diyruz/flower/firmwares/README.md

Downalod from github [releases](https://github.com/diyruz/flower/releases)
