diyruz/flower/images/device.jpg

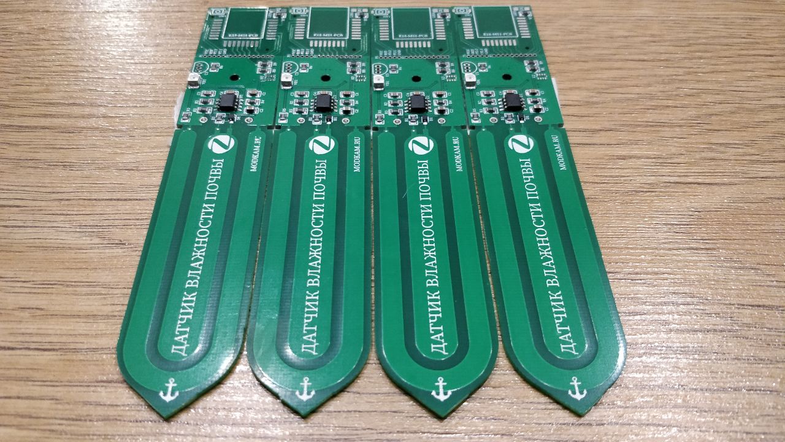
images/device.jpg
