diyruz/flower/hardware/v2/BOM_Flower_V2.xlsx

ID | Name | Designator | Footprint | Quantity
1 | 1N4148WS T4 | D1 | SOD-323_L1.8-W1.3-LS2.5-FD | 1
2 | 0.5pF | C1 | C0805 | 1
3 | 1M | R2 | R0805 | 1
4 | 220uF 10V CASE-D | C2 | CAP-SMD_L7.3-W4.3-R-RD | 1
5 | AAA_HOLDER (https://aliexpress.ru/item/32890176827.html) | G$1 | AAA_HOLDER | 1
9 | 1K | R4 | R0805 | 1
10 | T.Switch3x4x2 (https://s.click.aliexpress.com/e/_dXW0BgH) | SW1 | SWITCH-3.0*4.0 | 1
11 | 3528-PTSM D3528 (https://lcsc.com/product-detail/Ambient-Light-Sensors_JCHL-Shenzhen-Jing-Chuang-He-Li-Tech-3528-PTSM-D3528_C242256.html) | VD1 | LED-SMD_L3.5-W2.8-LS3.6-RD | 1
13 | DS18B20 (https://s.click.aliexpress.com/e/_dSyrU41) | U2 | TO-92-3_L4.9-W3.7-P1.27-L | 1
14 | 10K | R3*,R1 | R0805 | 2
15 | E18-MS1-PCB (https://s.click.aliexpress.com/e/_dZlpYLx) | U6 | E18-MS1-PCB_FLOWER | 1
16 | LED1206 | LED1 | LED 1206 | 1
17 | BME280 (https://s.click.aliexpress.com/e/_dTR9wKV) | U1 | LGA-8_BME280 | 1
18 | BME280 (https://s.click.aliexpress.com/e/_Bf9ER9sh) | U3 | DIP-1X4P2.54 | 1
19 | BS-2-1 (https://s.click.aliexpress.com/e/_dU8ZTmv) | B1 | CR2032 | 1
