diyruz/flower/(threads)

Thread 1 (2020-10-16):

Not really an issue but a question and a request

jumping2000, 2020-10-16:
Hi,
just two questions;

1. does the "flower" firmware work only with bme280 sensor?
2 I read here https://modkam.ru/?p=1671 that the measurement and transmission interval is 1 minute, is it possbile to change to 15 minute?

thank you for the great work

nurikk, 2020-10-26:
Hi, reporting interval is 30 minutes. It only supports bme280 and ds1820 sensors

jumping2000, 2020-10-30:
Perfect! thank you!

Closed 2020-10-30.

Thread 4 (2020-11-29):

buy asselbled sensor

Bartekn86, 2020-11-29:
Hi,
Where can i buy it  ? :-)

Zaitsev-ap, 2020-12-07:
> Hi,
> Where can i buy it ? :-)

Hi, buy it at telegram group
https://t.me/zigberu

Bartekn86, 2020-12-07:
thanks for replay,
Is there any other option to buy it ? tinde ?   this telegram group is hard for me :-) hard to translate :-)))

maumi, 2021-01-30:
where do you live? Which country?

Bartekn86, 2021-01-30:
poland

maumi, 2021-01-30:
Reed counter? I use a simple variant with cc2530 to count my gas counter.

Bartekn86, 2021-01-30:
cc2530 will drill  battery to fast

maumi, 2021-01-30:
It's not a problem of the cc2530. On a cold day you have 2000-4000 events (open+close) so you won't find a device battery based which lasts long.
Why not ac-powered?
Btw: i think we should stop being OT

Thread 5 (2020-12-09):

custom sensor

jumping2000, 2020-12-09:
I built a custom and very compact version of  your "flower" sensor  with only BME280 sensor and It seems to work!
the only problem is with the attribute exposed to Home Assistant, I have some attribute with "_1", maybe there is something strange in the "converter file"?

battery: 100
humidity: 88.42
illuminance: 2959
illuminance_1: 2954
illuminance_lux: 2
illuminance_lux_1: 2
linkquality: 33
pressure: 964.7
soil_moisture: 100
temperature_1: 21.21
temperature_bme: 22.6
voltage: 3500
unit_of_measurement: °C
friendly_name: 0x00124b001bdd56d3_temperature
device_class: temperature

thank you

jumping2000, 2020-12-09:
I use 2.03 firmware and related "conveerter file"

nurikk, 2020-12-20:
z2m natively supports this sensor, no external converter required

jumping2000, 2020-12-24:
> z2m natively supports this sensor, no external converter required

I removed the converter from z2m configuration but I have some strange data ending with "_1", is it normal?

{
    "battery": 52,
    "humidity": 64.48,
    "humidity_1": 47.71,
    "illuminance": 1911,
    "illuminance_1": 2615,
    "illuminance_lux": 2,
    "illuminance_lux_1": 2,
    "linkquality": 36,
    "pressure": 979.3,
    "pressure_1": 965,
    "soil_moisture": 100,
    "temperature_1": 26.61,
    "temperature_bme": 19.7,
    "voltage": 2900
}

jumping2000, 2021-01-13:
solved after 2-3 re-pairing end new version of zigbee2mqtt, Now I have the correct sensor!

Closed 2021-01-13.

Thread 6 (2020-12-21):

Change reporting interval

maumi, 2020-12-21:
Hey I really like your sensor and using it.
I want to "abuse" some of them as temperature sensors. Would it be possible that you build a version with APP_REPORT_DELAY set to 10 Minutes?
Or otherwise do i really need IAR to compile it on my own?
Thanks

maumi, 2020-12-22:
Changing the report interval in the converter did the trick.
I also compiled it on my own (with IAR) but something seems to gone wrong. The first app_delay after startup works (for exampe 5 Minutes) but then the device resend every second and won't sleep.

PS: Since your converter code is included in z2m converter you could change the readme because it's not necessary anymore.

Closed 2020-12-22.

Thread 7 (2021-01-13):

Connection issues

ftp27, 2021-01-13:
I've just finished my the very first device and faced with a problem with a strange behaviour when it already paired. A led continues blinking from time to time (like it in pair mode) and I don't see any updates from the device except finished interview by zigbee2mqtt and state:
```json
{
    "battery": 16,
    "soil_moisture": 100,
    "voltage": 3200
}
```
I don't know if its hardware problem or software but PCB has the minimum amount of components, the build only for soil moisture measures. Is it compulsory to have the whole set of sensors for the firmware (v2.0.4) and what can affect to such behaviour?

mkocus, 2021-02-06:
Got similar issue. It was basically caused by issue on the PCB assembly and/or zigbee interference with BT/WiFI.
It seems that the sensor was was not able to be configure correctly somehow.

ftp27, 2021-04-09:
So. I've soldered another board. With components
- R1, R2, R4
- C1
- D1
- LED1
- SW1
- U6
- CR2032
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
Only for soil humidity measure. Its still nothing but now I receive more data
```
{
    "battery": 14.5,
    "illuminance": 6,
    "illuminance_1": 16,
    "illuminance_lux": 1,
    "illuminance_lux_1": 1,
    "linkquality": 91,
    "pressure": 0,
    "soil_moisture": 0,
    "temperature_bme": 0,
    "voltage": 2900
}
```
The battery is new, but shows 14.5% Is it possible that firmware didn't adapt for CR2032 battery?

RomanDidenko, 2021-04-09:
C2 is required with CR2032

ftp27, 2021-04-09:
@RomanDidenko
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

ftp27, 2021-04-09:
@RomanDidenko
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
`C5` from v1 is `C2` in v2

ftp27, 2021-04-09:
After 3 hours of work the battery is dead I suppose. It stopped sending any data.

RomanDidenko, 2021-04-09:
[image: image.png]
[image: image.png]
This screenshot is taken from ready devices at https://t.me/zigberu

сб, 10 апр. 2021 г. в 01:14, Aleksei Cherepanov ***@***.***>:

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

--
Best Regards,
Roman

ftp27, 2021-04-12:
@RomanDidenko  It seems you how some problems with attachments )

RomanDidenko, 2021-04-12:
Sorry for that.
I've updated my comment but the images still not auto-expanded :(.
As I see links are valid and one can follow them.

ftp27, 2021-04-13:
@RomanDidenko Thank you for the pictures. I'll try it

GSternik, 2021-06-09:
1. I have a problem with publishing zigbee2mqtt notification of Flowers device (Domoticz).
When mqtt service is restarting I get:
cze 09 10:11:02 raspberrypi npm[503]: Zigbee2MQTT:info  2021-06-09 10:11:02: 0x00124b00225734bb (0x00124b00225734bb): DIYRuZ_Flower - DIYRuZ [Flower sensor](http://modkam.ru/?p=1700) (EndDevice)
cze 09 10:11:02 raspberrypi npm[503]: Zigbee2MQTT:info  2021-06-09 10:11:02: 0x00124b0022573477 (0x00124b0022573477): DIYRuZ_Flower - DIYRuZ [Flower sensor](http://modkam.ru/?p=1700) (EndDevice)

 Zigbee2MQTT:info  2021-06-09 08:55:37: MQTT publish: topic 'zigbee2mqtt/0x00124b0022573477', payload '{"battery":100,"illuminance":534,"illuminance_lux":1,"pressure":null,"soil_moisture":100,"temperature_ds":0,"voltage":3100}'

 Zigbee2MQTT:info  2021-06-09 08:55:37: MQTT publish: topic 'zigbee2mqtt/0x00124b00225734bb', payload '{"battery":76,"illuminance":555,"illuminance_lux":1,"pressure":null,"soil_moisture":100,"voltage":3000}'
After that the sensors do not send messages for zigbee2mqtt service.

Firstly I got message from converter:
{"dateCode":"22/04/2021 11:13","description":"[Flower sensor](http://modkam.ru/?p=1700)","friendly_name":"0x00124b00225734bb","hardwareVersion":1,"ieeeAddr":"0x00124b00225734bb","lastSeen":1623097284351,"manufacturerID":0,"manufacturerName":"modkam.ru","model":"DIYRuZ_Flower","modelID":"DIYRuZ_Flower","networkAddress":44718,"powerSource":"Battery","softwareBuildID":"22/04/2021 11:13","type":"EndDevice","vendor":"DIYRuZ"},{"dateCode":"22/04/2021 11:13","description":"[Flower sensor](http://modkam.ru/?p=1700)","friendly_name":"0x00124b0022573477","hardwareVersion":1,"ieeeAddr":"0x00124b0022573477","lastSeen":1623224768376,"manufacturerID":0,"manufacturerName":"modkam.ru","model":"DIYRuZ_Flower","modelID":"DIYRuZ_Flower","networkAddress":56759,"powerSource":"Battery","softwareBuildID":"22/04/2021 11:13","type":"EndDevice","vendor":"DIYRuZ"}],"type":"devices"}'.

2. Now I have two DS18B20 sensors in the devices. Data pins are connected to P1.3 and Vdd to P1.1. At pin P1.1 is not any voltage for supply this sensors. My guess is that it might show up when the microprocessor is waking up. However, I don't have any sensor data.
How to resolve or debbug this problems?

bojanpotocnik, 2021-06-09:
> Now I have two DS18B20 sensors in the devices.

Try with just one connected DS18B20 sensor, this device does not support reading nor reporting values of multiple DS18B20 sensors on single 1w bus. And you are correct, sensors are powered only while being read ([source](https://github.com/diyruz/flower/blob/master/Source/zcl_app.c#L238-L254)).

It is also possible that you have [counterfeit](https://github.com/cpetrich/counterfeit_DS18B20)/dead DS18B20 (happened to me).

Also, it is better to open a new issue or using more related one. Here we are waiting for @ftp27 to report and close this issue.

Thread 9 (2021-01-29):

New function or a great idea

ingo01978, 2021-01-29:
Hello, I am very excited about this project.  Now my wife got the idea to let the LED blink if the value falls below an adjustable value.  Would that be possible?  Can you set the humidity to zero by hand?  My sensors all show 20% in the dry.  LG Ingo

shajek, 2021-01-30:
Hello, i want to write about calibration. In my expirience with capacity and resistant type of probe, There is a need to use the maximum and minimum moisture calibration of the soil.  Normally is needed to bake your soil, measure minimum humidity, and water the soil to maximum  and that numbers represent as 0-100%. Is there any chance to implement min/max calibration in your great project ?

nurikk, 2021-02-01:
You're using a bad diode, try the replace it

Closed 2023-03-23.

Thread 10 (2021-01-31):

Compilation requirements

shajek, 2021-01-31:
Hello,
thank you for your work. However, can you add simple describe for IDE/enviroment where you compile FW, or what you need to compile ?

Thank you

genboo, 2021-02-01:
TI Z-Stack 3.0.2 + IAR Embedded workbench IDE (8051)

MatthijsThijssen, 2021-05-30:
Hi, Thanks for this nice project! I think I do something wrong, or maybe I am missing something...
I install the IAR Embedded Workbench environment and the Texas Instruments Z-Stack 3.0.2 but as soon as I will load the project I got a message: "Unable to create configuration "CHDTECH_DEV" using toolchain 8051" Has someone an idea? (Yes, the IAR environment and Z Stack is new for me ;-) Thanks!

bojanpotocnik, 2021-05-30:
Have you tried the steps linked by **nurikk** in issue https://github.com/diyruz/flower/issues/21?

MatthijsThijssen, 2021-06-01:
Thanks bojanpotocnik, it helps a lot. I have some compiling issues to solve (maybe because i have version 10.40 and can't find the 10.30 version)...

bojanpotocnik, 2021-06-01:
@MatthijsThijssen are you getting the following?
```
Error[e46]: Undefined external "?B" referred in bdb_Reporting ( D:\Git\diyruz\flower\CC2530DB\CHDTECH_DEV\Obj\bdb_Reporting.r51 )
Error[e46]: Undefined external "?IE" referred in ?ALLOC_XSTACK8 ( C:\Program Files (x86)\IAR Systems\Embedded Workbench 8.3\8051\LIB\CLIB\cl-pli-blxd-1e16x01.r51 )
Error while running Linker

Total number of errors: 2
Total number of warnings: 11
```

bojanpotocnik, 2021-06-01:
@MatthijsThijssen are you getting the following?
```
Error[e46]: Undefined external "?B" referred in bdb_Reporting ( ...\flower\CC2530DB\CHDTECH_DEV\Obj\bdb_Reporting.r51 )
Error[e46]: Undefined external "?IE" referred in ?ALLOC_XSTACK8 ( C:\Program Files (x86)\IAR Systems\Embedded Workbench 8.3\8051\LIB\CLIB\cl-pli-blxd-1e16x01.r51 )
Error while running Linker

Total number of errors: 2
Total number of warnings: 11
```

MatthijsThijssen, 2021-06-01:
Yes, your right! As far as i can see it is related to the current version of IAR WB 10.40

It isn't simple to get version 10.30 and i need to figure out how to solve this so i can use 10.40

I saw a message by TI website about this issue but didn't spend enough time to see if it could be solved...

MatthijsThijssen, 2021-06-01:
https://e2e.ti.com/support/wireless-connectivity/zigbee-thread-group/zigbee-and-thread/f/zigbee-thread-forum/999931/cc2530-cc2530-linking-issues-with-lates-iar-8051-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

MatthijsThijssen, 2021-06-01:
Ok, booked some succes. I changed the linker and i changed the cc2530F256.xcl file. Looks solved now. (I got a HEX file, not tested yet)

MatthijsThijssen, 2021-06-12:
Hi all, Thanks again for this nice build project! I still have some issues. I can compile the source, got a working HEX file but it differs from the original HEX file... In the original HEX file I see the LED works correct. In my compiled version the LED is very dimmed. Beside that it works but for some reason the board stopped working when the batteries are below 2.8 Volt. I think I need to do something with the compiler environment to define the correct destination (chip and/or destination environment)? Are there "thinks to know" by using the IAR development software? Thanks in advance and keep up the good work!

nurikk, 2021-07-17:
Kindly refer to this manual to setup your development environment https://zigdevwiki.github.io/Begin/IAR_install.html

Thread 11 (2021-02-02):

MQTT Configuration issue

mkocus, 2021-02-02:
Hello,
got the following configuration issue on assembled device:
```
INFO: Starting interview of '0x00124b00220281c6'
INFO: Successfully interviewed '0x00124b00220281c6', device has successfully been paired
INFO: Device '0x00124b00220281c6' is supported, identified as: DIYRuZ [Flower sensor](http://modkam.ru/?p=1700) (DIYRuZ_Flower)
INFO: Configuring '0x00124b00220281c6'
INFO: MQTT publish: topic 'zigbee2mqtt/bridge/log', payload '{"message":"interview_successful","meta":{"description":"[Flower sensor](http://modkam.ru/?p=1700)","friendly_name":"0x00124b00220281c6","model":"DIYRuZ_Flower","supported":true,"vendor":"DIYRuZ"},"type":"pairing"}'
INFO: MQTT publish: topic 'homeassistant/sensor/0x00124b00220281c6/soil_moisture/config', payload '{"availability":[{"topic":"zigbee2mqtt/bridge/state"}],"device":{"identifiers":["zigbee2mqtt_0x00124b00220281c6"],"manufacturer":"DIYRuZ","model":"[Flower sensor](http://modkam.ru/?p=1700) (DIYRuZ_Flower)","name":"0x00124b00220281c6","sw_version":"Zigbee2MQTT 1.17.0"},"icon":"mdi:water-percent","json_attributes_topic":"zigbee2mqtt/0x00124b00220281c6","name":"0x00124b00220281c6 soil moisture","state_topic":"zigbee2mqtt/0x00124b00220281c6","unique_id":"0x00124b00220281c6_soil_moisture_zigbee2mqtt","unit_of_measurement":"%","value_template":"{{ value_json.soil_moisture }}"}'
INFO: MQTT publish: topic 'homeassistant/sensor/0x00124b00220281c6/battery/config', payload '{"availability":[{"topic":"zigbee2mqtt/bridge/state"}],"device":{"identifiers":["zigbee2mqtt_0x00124b00220281c6"],"manufacturer":"DIYRuZ","model":"[Flower sensor](http://modkam.ru/?p=1700) (DIYRuZ_Flower)","name":"0x00124b00220281c6","sw_version":"Zigbee2MQTT 1.17.0"},"device_class":"battery","json_attributes_topic":"zigbee2mqtt/0x00124b00220281c6","name":"0x00124b00220281c6 battery","state_topic":"zigbee2mqtt/0x00124b00220281c6","unique_id":"0x00124b00220281c6_battery_zigbee2mqtt","unit_of_measurement":"%","value_template":"{{ value_json.battery }}"}'
INFO: MQTT publish: topic 'homeassistant/sensor/0x00124b00220281c6/illuminance/config', payload '{"availability":[{"topic":"zigbee2mqtt/bridge/state"}],"device":{"identifiers":["zigbee2mqtt_0x00124b00220281c6"],"manufacturer":"DIYRuZ","model":"[Flower sensor](http://modkam.ru/?p=1700) (DIYRuZ_Flower)","name":"0x00124b00220281c6","sw_version":"Zigbee2MQTT 1.17.0"},"device_class":"illuminance","json_attributes_topic":"zigbee2mqtt/0x00124b00220281c6","name":"0x00124b00220281c6 illuminance","state_topic":"zigbee2mqtt/0x00124b00220281c6","unique_id":"0x00124b00220281c6_illuminance_zigbee2mqtt","unit_of_measurement":"-","value_template":"{{ value_json.illuminance }}"}'
INFO: MQTT publish: topic 'homeassistant/sensor/0x00124b00220281c6/humidity/config', payload '{"availability":[{"topic":"zigbee2mqtt/bridge/state"}],"device":{"identifiers":["zigbee2mqtt_0x00124b00220281c6"],"manufacturer":"DIYRuZ","model":"[Flower sensor](http://modkam.ru/?p=1700) (DIYRuZ_Flower)","name":"0x00124b00220281c6","sw_version":"Zigbee2MQTT 1.17.0"},"device_class":"humidity","json_attributes_topic":"zigbee2mqtt/0x00124b00220281c6","name":"0x00124b00220281c6 humidity","state_topic":"zigbee2mqtt/0x00124b00220281c6","unique_id":"0x00124b00220281c6_humidity_zigbee2mqtt","unit_of_measurement":"%","value_template":"{{ value_json.humidity }}"}'
INFO: MQTT publish: topic 'homeassistant/sensor/0x00124b00220281c6/pressure/config', payload '{"availability":[{"topic":"zigbee2mqtt/bridge/state"}],"device":{"identifiers":["zigbee2mqtt_0x00124b00220281c6"],"manufacturer":"DIYRuZ","model":"[Flower sensor](http://modkam.ru/?p=1700) (DIYRuZ_Flower)","name":"0x00124b00220281c6","sw_version":"Zigbee2MQTT 1.17.0"},"device_class":"pressure","json_attributes_topic":"zigbee2mqtt/0x00124b00220281c6","name":"0x00124b00220281c6 pressure","state_topic":"zigbee2mqtt/0x00124b00220281c6","unique_id":"0x00124b00220281c6_pressure_zigbee2mqtt","unit_of_measurement":"hPa","value_template":"{{ value_json.pressure }}"}'
INFO: MQTT publish: topic 'homeassistant/sensor/0x00124b00220281c6/temperature_ds/config', payload '{"availability":[{"topic":"zigbee2mqtt/bridge/state"}],"device":{"identifiers":["zigbee2mqtt_0x00124b00220281c6"],"manufacturer":"DIYRuZ","model":"[Flower sensor](http://modkam.ru/?p=1700) (DIYRuZ_Flower)","name":"0x00124b00220281c6","sw_version":"Zigbee2MQTT 1.17.0"},"json_attributes_topic":"zigbee2mqtt/0x00124b00220281c6","name":"0x00124b00220281c6 temperature ds","state_topic":"zigbee2mqtt/0x00124b00220281c6","unique_id":"0x00124b00220281c6_temperature_ds_zigbee2mqtt","unit_of_measurement":"°C","value_template":"{{ value_json.temperature_ds }}"}'
INFO: MQTT publish: topic 'homeassistant/sensor/0x00124b00220281c6/temperature_bme/config', payload '{"availability":[{"topic":"zigbee2mqtt/bridge/state"}],"device":{"identifiers":["zigbee2mqtt_0x00124b00220281c6"],"manufacturer":"DIYRuZ","model":"[Flower sensor](http://modkam.ru/?p=1700) (DIYRuZ_Flower)","name":"0x00124b00220281c6","sw_version":"Zigbee2MQTT 1.17.0"},"json_attributes_topic":"zigbee2mqtt/0x00124b00220281c6","name":"0x00124b00220281c6 temperature bme","state_topic":"zigbee2mqtt/0x00124b00220281c6","unique_id":"0x00124b00220281c6_temperature_bme_zigbee2mqtt","unit_of_measurement":"°C","value_template":"{{ value_json.temperature_bme }}"}'
INFO: MQTT publish: topic 'homeassistant/sensor/0x00124b00220281c6/linkquality/config', payload '{"availability":[{"topic":"zigbee2mqtt/bridge/state"}],"device":{"identifiers":["zigbee2mqtt_0x00124b00220281c6"],"manufacturer":"DIYRuZ","model":"[Flower sensor](http://modkam.ru/?p=1700)
INFO: MQTT publish: topic 'homeassistant/sensor/0x00124b00220281c6/linkquality/config', payload '{"availability":[{"topic":"zigbee2mqtt/bridge/state"}],"device":{"identifiers":["zigbee2mqtt_0x00124b00220281c6"],"manufacturer":"DIYRuZ","model":"[Flower sensor](http://modkam.ru/?p=1700) (DIYRuZ_Flower)","name":"0x00124b00220281c6","sw_version":"Zigbee2MQTT 1.17.0"},"icon":"mdi:signal","json_attributes_topic":"zigbee2mqtt/0x00124b00220281c6","name":"0x00124b00220281c6 linkquality","state_topic":"zigbee2mqtt/0x00124b00220281c6","unique_id":"0x00124b00220281c6_linkquality_zigbee2mqtt","unit_of_measurement":"lqi","value_template":"{{ value_json.linkquality }}"}'
ERROR: Failed to configure '0x00124b00220281c6', attempt 1 (Error: Bind 0x00124b00220281c6/1 genPowerCfg from '0x00212effff065bda/1' failed (Error: status: 140) at DeconzAdapter.<anonymous> (/zigbee2mqtt-1.17.0/node_modules/zigbee-herdsman/dist/adapter/deconz/adapter/deconzAdapter.js:660:23) at Generator.next (<anonymous>) at fulfilled (/zigbee2mqtt-1.17.0/node_modules/zigbee-herdsman/dist/adapter/deconz/adapter/deconzAdapter.js:24:58))
```

My hardware configuration is:
- modkam.ru flower sensor, running 2.0.5 firmware
- rasberry pi running Home Assistant (latest version)
- Conbee2 zigbee coordinator
- Zigbee2MQTT

Any ideas?

mkocus, 2021-02-06:
It seems that the issue was caused by the zigbee interference or badly assembled sensor. I've assembled 2 more, and didn't have that issue again. Closing.

Closed 2021-02-06.

Thread 13 (2021-02-13):

Soil moisture scalling

mkocus, 2021-02-13:
Would it be possible to provide some interface to scale the soil moisture to a given range?

My sensor shows 0% when in air, 100% when plant is fully watered, but when the plan soil is very dry (depends on the soil type) it shows like 60 or 80.

nurikk, 2021-03-07:
no plans for implementing this, contributions are always welcome

Bartekn86, 2021-10-16:
+1

I have the same readings, 100 % max, minumum 70 %...    if it is possible, could you write some calibration ?

thank you

Thread 14 (2021-02-24):

не отсылает данные

Garkus98, 2021-02-24:
Здравствуйте. я собрал датчик и загрузил прошивку последнюю. он заджойнился в устройстве sls gateway но не отсылает никакие данные. потом я пытался и прошивал другой датчик разными прошивками но увы они не отсылают тоже данные
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

Closed 2021-02-24.

Thread 15 (2021-03-28):

Phototransistor polarity

senarvi, 2021-03-28:
I'm confused about which way I should mount the phototransistor. I found the [datasheet](https://datasheet.lcsc.com/szlcsc/1912271606_JCHL-Shenzhen-Jing-Chuang-He-Li-Tech-PTSMD3528_C242256.pdf) and it says that the notch marks the anode. I guess that means the emitter, i.e. the end that is connected to the resistor. Also in the board there's a dot marked on that side, so I would think that the notch in the phototransistor should be placed where the dot is. However, in the [pictures](https://github.com/diyruz/flower/blob/master/images/DIYRuZ_Flower_8.png) it looks like the notch is on the other side. Also, when measuring the resistance I get maybe more sane values (100 Ω - 100 kΩ depending on the light) when I place the positive probe to the notch side, so that makes me think that the notch marks the collector, but I don't know if I can measure the resistance reliably with a digital multimeter.

Thread 16 (2021-04-12):

Update interval of the sensors

shadowmdk, 2021-04-12:
Is it possible to reduce the sensor update interval to 15 minutes, or better than 10? As a meteosensor, the current interval is absolutely not informative

nurikk, 2021-04-22:
You can build firmware by yourself and define any intervals

mrazekfilip, 2021-04-28:
Where can I find definition of update interval in the firmware code? From my experience the update interval is 30 minutes, but I found only minimumReportInverval, maximumReportInterval which is set to 0 and 3600 respectively.

nurikk, 2021-04-30:
it's called `APP_REPORT_DELAY`

Thread 17 (2021-04-17):

Mention in README how to purchase these

onedr0p, 2021-04-17:
I know there's some fun to have these boards created but I don't know why it's not mentioned on the README. What is the current way to purchase and built these devices?

bojanpotocnik, 2021-04-22:
I ordered them as described on the [author's article](http://modkam.ru/?p=1832)
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
That is 4.13$ delivered to my door (customs handled by JLCPCB because I selected that option and it was included in shipping price).

The only thing I needed to solder was the battery holder, which is also the easiest part to solder, or at least worth to learn a bit of soldering for the price difference.

Already happily using more than half of them :)

jamiekris, 2022-07-07:
Is there any way now to get a hold of this kit? Does this ship from Russia?

Closed 2023-10-11.

Thread 18 (2021-04-19):

E18 MS1PA2-PCB

shajek, 2021-04-19:
Hello, please, is there any FW for E18 MS1PA2-PCB ? Please, can you compile it for this module ? I need it for longer range in garden and i have it already soldered then i realize, that FW for E18 MS1-PCB is not compatibile due PA.

Thank you

nurikk, 2021-04-22:
Hi, there is no MS1PA2 build. You can build it on your own

bojanpotocnik, 2021-04-22:
I suggest you add a repeater using yours or similar module (like [this one](https://github.com/tube0013/tube_gateways/tree/main/tube_cc_router) using [RF-BM-2652P2](https://www.szrfstar.com/product/237-en.html)), but with IPEX connector and external antenna instead of PCB antenna ([any](https://www.aliexpress.com/wholesale?SearchText=ipex+antenna) will do)! Well, I don't know your case, but maybe even the simplest CC253x repeater will do.

In this case, you have the following benefits:
- You can use plenty of [Flower v3](http://modkam.ru/?p=1832) costing you <5$ per piece delivered to your door (JLCPCB assembly) which is less than cost of E18 MS1PA2-PCB alone
- Battery in sensors will last longer, because you don't need to power LNA in MS1PA2-PCB
- Repeater can have a larger battery or be connected to main power

I ordered 30 sensors and have 18 already set-up. In the house I use [this antenna](https://www.alfa.com.tw/products/ars-n19?variant=36473964986440) attached to repeater, outside I use [this one](https://www.alfa.com.tw/products/apa-m04?variant=36473963806792), directed to the garden, picking up 8 v3 sensors up to 60 m away (haven't tested further). So yeah, in my opinion it is not worth spending time and money for replacing modules - that's why repeaters are for.

shajek, 2021-04-26:
Thank you both :) Problem is, that module is already soldered and equipped with solar panel for energy demand. Programming and making electronics is favorite hobby.

bojanpotocnik, thank you for advice, specialy for v3 version. I am aware of concept of repeater, i have whole house covered, but making PA version with aditional solar charging is "hobby and fun" and maybe better experience :)

@nurikk thank you too, for advice. I dont own IAR, i try time trial version. Installed zstack, make all dependencies OK, make imports all right, but
```
Building configuration: GenericApp - DIYRuZ_Flower
Updating build tree...
Performing Pre-Build Action
OSAL_Math.s51
Warning[410]: B is using fixed address 0xF0. Use external label ?B instead if B is using another address C:\Components\osal\mcu\cc2530\OSAL_Math.s51 108
Warning[410]: B is using fixed address 0xF0. Use external label ?B instead if B is using another address C:\Components\osal\mcu\cc2530\OSAL_Math.s51 185
version.c
Linking
Warning[w6]: Type conflict for external/entry "GetBindingTableEntry", in module APS against external/entry in module BindingTable; function return types are different; class/struct/union types have different
sizes
Warning[w6]: Type conflict for external/entry "bindFind", in module APS against external/entry in module BindingTable; function return types are different; class/struct/union types have different sizes
Warning[w6]: Type conflict for external/entry "bindFindExisting", in module APS against external/entry in module BindingTable; function return types are different; class/struct/union types have different sizes
Warning[w6]: Type conflict for external/entry "bindIsClusterIDinList", in module APS against external/entry in module BindingTable; function types differ in parameter 1; class/struct/union types have different
sizes
Warning[w6]: Type conflict for external/entry "bindRemoveClusterIdFromList", in module APS against external/entry in module BindingTable; function types differ in parameter 1; class/struct/union types
have different sizes
Warning[w6]: Type conflict for external/entry "bindRemoveEntry", in module APS against external/entry in module BindingTable; function types differ in parameter 1; class/struct/union types have different
sizes
Warning[w6]: Type conflict for external/entry "pbindAddEntry", in module APS against external/entry in module BindingTable; function return types are different; class/struct/union types have different sizes
Error[e46]: Undefined external "?B" referred in bdb_Reporting ( C:\Texas Instruments\Z-Stack 3.0.2\Projects\flower\CC2530DB\DIYRuZ_Flower\Obj\bdb_Reporting.r51 )
Error[e46]: Undefined external "?IE" referred in ?ALLOC_XSTACK8 ( E:\8051\LIB\CLIB\cl-pli-blxd-1e16x01.r51 )
Error while running Linker

Total number of errors: 2
Total number of warnings: 9

```

because of this, i kindly ask, if you can make hex for PA2 (i know that, for CO2 meter is available)

thank you both

nurikk, 2021-05-04:
I don’t have time for PA build implementation.
https://zigdevwiki.github.io/Begin/IAR_install/

@shajek you should use IAR v 10.30 or 10.40

Closed 2021-05-04.

Thread 19 (2021-04-23):

Query U1 U2 U3

aidbish, 2021-04-23:
In the V2 picture
https://github.com/diyruz/flower/blob/master/images/DIYRuZ_Flower_V2-5.png

Are U1 U2 U3 no longer required as listed in the BOM, but in picture not installed?

grego1981, 2021-04-23:
I'd like to know if there is a flash defentive flash guide!

grego1981, 2021-04-23:
I have used the guide in this URL -->  https://zigbee.blakadder.com/Ebyte_E18-MS1-PCB.html
using the ccdebuger method --> https://ptvo.info/how-to-select-and-flash-cc2530-144/

The debuger flashes the image with error in verification (CC2530 - ID1258: Error in HEX file verification) the module does not seem to work... Is there any test file  to check?? Anyhting to test prior to flashing?

linuxrrze, 2021-04-24:
AFAIK U1 and U2 are optional sensors. If equipped their values are reported, if not (default) their values are "0".

grego1981, 2021-04-24:
OK had a breakthrough, I have managed to flash and read the chip by connecting the cc debuger to the board, ommiting the power link. I connected the battery as a power input for the chip. Now it flashes and passes the verification.

The problem of connection remains, I cannot make it connect to the gateway, I tried holding the button more than 10secs to reset to no avail.... How do youmake it connect!!??

grego1981, 2021-04-28:
The problem was the button, it was defective, I have changed it and it works when long pressing it both the VD1 and LED1 light up every 3 secs (while holding) but HA zigbee2mqtt does not find the device... Is there any procedure tojoin? Anyway to debug the behaviour?

bojanpotocnik, 2021-04-28:
@grego1981 are you sure about VD1 (PTSMD3528) also lighting up? :raised_eyebrow:

Otherwise, procedure [described here](https://github.com/diyruz/flower#how-to-join) + clicking _Permit join (All)_ in Zigbee2mqtt works for me.

grego1981, 2021-04-28:
Yes, It was to curious to me as well.... When I press and hold it flasshes 1 time and then three faster, then it does not flash at all. I'll try to upload a video of it..

grego1981, 2021-04-28:
https://drive.google.com/file/d/14oaWWbRJhI-b1aqj9ErwmWVT1dMnpDkP/view?usp=sharing

bojanpotocnik, 2021-04-28:
I tried my V3 sensors with power supply set to 3.00V/1.0mA and 3.30V/3.0mA: while LED1 shines bright white in both cases, phototransistor VD1 does not light up. Weird that yours actually shines.

Anyway, I noticed that there is IPEX/U.FL connector on your module. Are you using [E18-MS1-IPX](https://www.ebyte.com/en/product-view-news.html?id=124)? In that case you shall attach the [antenna](https://www.aliexpress.com/wholesale?SearchText=antenna+ipex), otherwise RF part cannot work.

grego1981, 2021-04-28:
Ah this does makes sense..
I bought the modules bellow and have the V2 boards.
https://www.ebay.com/itm/192164529297

grego1981, 2021-04-28:
> I tried my V3 sensors with power supply set to 3.00V/1.0mA and 3.30V/3.0mA: while LED1 shines bright white in both cases, phototransistor VD1 does not light up. Weird that yours actually shines.
>
> Anyway, I noticed that there is IPEX/U.FL connector on your module. Are you using [E18-MS1-IPX](https://www.ebyte.com/en/product-view-news.html?id=124)? In that case you shall attach the [antenna](https://www.aliexpress.com/wholesale?SearchText=antenna+ipex), otherwise RF part cannot work.

You were correct, I found and installed a 2.4 sma antenna and managed to join it. Now Have to find out why no sensor works...
Thank you for your help!

grego1981, 2021-05-04:
So the sensor got discovered and at some point the battery was detected but low (about 12%) I even saw some data from the sensors briefly but after some time, all data was N/A and only the signal strength is displayed... I deleted and rejoined to no avail, I changed the battery as well.
I use the latest released hex file.

bojanpotocnik, 2021-05-04:
Can you please configure zigbee2mqtt as such
```
advanced:
  log_level: debug
zigbee_herdsman_debug: true
```
and then provide log output after you re-join the sensor? Force remove it first, rejoin (as described in README.md in this repo) and then press the button after a while to update the state.

robotm-team, 2021-06-07:
> AFAIK U1 and U2 are optional sensors. If equipped their values are reported, if not (default) their values are "0".

I will ask because I don't know if I understand this correctly:
Will a plate made as in the photo DIYRuZ_Flower_V2-5.png, that is without U1, U2 and U3 will it only report soil moisture and insolation?
Installing U2 will add ambient temperature report?
Installing U1 or U3 will add air pressure, humidity and temperature but only ambient?
Does it make sense to install U2 if you install U1 or U3?

bojanpotocnik, 2021-06-08:
> Does it make sense to install U2 if you install U1 or U3?

I think it is meant that you add this (left one) as U2
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
and stick it in the soil - then you have soil humidity+temperature + air humidity+pressure+temperature, which makes sense again.

> nothing appears in the debug log

Have you enabled all debug as I suggested above? And LED flickers like it is sending something, but totally nothing in the log (joining new devices permitted)? In that case I am also run out of ideas... I would try with another sensor first, to test HA/Z2M setup.

robotm-team, 2021-06-20:
Hi. One more question.
From what I've read VD1 (3528-PTSM D3528) which I can't find anywhere except LCSC and supplying only this one element from there is completely unprofitable, can be replaced with any photoresistor ( https://modkam.ru/?p=1700#comment-6226 ) like the one in the link in the quoted comment. However, there is a statement which I do not understand. I don't know Russian and I'm using online translator and it's not that helpful.
Question: What should be done with the resistor (I think it's R3) in the circuit Jager writes about?
"Только резистор в цепи подберите." - What to do with it :-) ? omit it (make a jumper or solder 0Ω) ? Give more than 10KΩ ? Sorry, but the translator suggests all these possibilities ...

bojanpotocnik, 2021-06-20:
When measuring illuminance, ADC peripheral [is set](https://github.com/diyruz/flower/blob/master/Source/zcl_app.c#L288) to use AVDD as a reference voltage, which is connected to VDD, meaning that voltages up to 3.3 V can be read on ADC pins. However, the circuit will work down to 2V VDD when battery empties, so you would want to limit your measured voltage to max. 2V to prevent saturating ADC input.

Checking [3528-PTSM D3528 datasheet](https://datasheet.lcsc.com/lcsc/1912271606_JCHL-Shenzhen-Jing-Chuang-He-Li-Tech-PTSMD3528_C242256.pdf) page 3/5

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

shows you that at 100 lux the current is 59 uA, resulting in ADC input voltage U = I*R = 59 uA * 10 k = 0.59 V.

So if you want to have the same values, you should measure photoresistor's resistance at 100 lux and then adjust the R3 so that the voltage divider output will be 0.59 V. But then you have another problem - LDRs are usually not linear
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
so values won't be the same anyway, so don't bother too much. Just measure the resistance at maximum brightness and adjust R3 so that the resulting value does not go over 2V.

As example, if you take LDR info from [this page](https://www.elprocus.com/ldr-light-dependent-resistor-circuit-and-working/)
> Typical resistance at 100lux is 0.7kΩ

and put this in voltage divider [calculator](https://ohmslawcalculator.com/voltage-divider-calculator) (Vs = 3V, R1 = 700 ohm, Vout = 2 V), you get that R2 (R3) shall be 1400 ohm.

robotm-team, 2021-06-20:
Thank you so much for your help and commitment.
So, if I understand correctly this circuit is fitted to this particular type and model. Well, too bad, I will have to do without it.Unless there is some other, more easily available model of photoresistor which can simply be soldered in and will match the parameters... From the calculator it looks like it should be 5kΩ at 100Lx to match R3 (10kΩ) on the board.
Maybe someday, additionally...
Unless you have a ready solution :-) ?

Translated with www.DeepL.com/Translator (free version)

MatthijsThijssen, 2021-06-20:
This one works well:

https://nl.rs-online.com/web/p/phototransistors/7103853/

Or this one:

https://nl.rs-online.com/web/p/photodiodes/1652707/

Met vriendelijke groet / Kind Regards,

Matthijs Thijssen
The Netherlands

(Verstuurd vanaf mijn iPhone)

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

bojanpotocnik, 2021-06-21:
Also check [this comment](https://modkam.ru/?p=1700#comment-5586) - you can add [I2C light sensor](https://ae01.alicdn.com/kf/HTB1HVxiQpXXXXcWaXXXq6xXFXXXx.jpg) instead of or in addition to BME280. This would result in calibrated light measurements, but also in increased cost and need of modifying the firmware.

Thread 20 (2021-04-25):

Feature Request: OTA Updates

linuxrrze, 2021-04-25:
Not a bug, just a feature request: OTA Updates

I'd love to see OTA updates for firmware releases.
Are there any plans to realize that?

So far I've only seen that on a few IKEA devices, however it'd be great to have this feature for more devices (especially if there's active development going on as in this project).

There's some documentation about how OTA can be done (I hope the mentioned Z-Stack is the same as the one used here):

https://e2e.ti.com/cfs-file/__key/communityserver-discussions-components-files/158/6888.Z_2D00_Stack-OTA-Upgrade-User_2500_27s-Guide.pdf

PS: Thanks for sharing this great project!

nurikk, 2021-04-26:
Hi, unfortunately there’s not enough flash size for ota

chrisrock1984, 2021-04-27:
would it still be possible to do OTA if the firmware only contains the code of moisture sensing?

nurikk, 2021-04-27:
I'm not sure about this, unfortunately I don't have time for this experiments and implementation.
If you want to try implement OTA by yourself kindly refer to TI official reference guide. All contributions are always welcome

[Z-Stack OTA Upgrade User's Guide.pdf](https://github.com/diyruz/flower/files/6382002/Z-Stack.OTA.Upgrade.User.s.Guide.pdf)

Hedda, 2021-11-29:
FYI, OTA would be possible if this Flower project was redesigned to newer Texas Instruments module like CC2652, see -> https://github.com/diyruz/flower/issues/43

Closed 2021-05-04.

Thread 22 (2021-04-27):

Cut down the cost of the PCB with panelization

elysion, 2021-04-27:
PCB fabrication services charge extra for PCBs that do not fit inside 10x10cm. As the width of the v2 design seems to be 128mm, additional charges are applied. Also as the height of the board height is 24mm, you could fit 4 of these inside a single design, further cutting the costs. I realise that the cost of the PCB is one of the cheapest parts of the design, but think that small tweaks would have a good ROI.

Would it be possible for you to make these changes or share the PCB designs in order for someone else to make them?

bojanpotocnik, 2021-04-27:
@elysion check [this comment](https://github.com/diyruz/flower/issues/17#issuecomment-825236065) - v3 is less than $5 fully assembled (except battery holder) delivered to your door - it hardly gets any cheaper. Maybe try using other fabrication service?

Otherwise this is still valid request, maybe someone is willing to do it anyway. Note, however, that sensing element should be of certain minimum size to be reliable, and you want RF part to be as away from the soil as possible. Interesting design would be separating the logic/RF/upper and sensing/lower part, each having pads to connect them with a e.g. ribbon cable. That would enable using different sizes of sensing elements (smaller or larger pots) or mounting RF part on the outside of the pod (not sticking up).

nurikk, 2021-05-04:
Kindly do panelisation and submit gerbers in 0R

bojanpotocnik, 2021-05-04:
@nurikk is it possible to publish original PCB design files or make EasyEDA project public? It is much harder to reverse engineer the gerber files and not much sense in reinventing the wheel. If the original project files would be available, I am sure someone (even me when I find some spare time) would be happy to do such improvements.

bojanpotocnik, 2021-06-07:
@nurikk do you have any information on my question above, or shall I ask Jager on Telegram?

nurikk, 2021-07-22:
Jager never shares sources, forget about it

Closed 2021-05-04.

Thread 23 (2021-05-04):

Would it be possible to use this as a basis for an ultrasonic sensor?

disaster123, 2021-05-04:
Hi,

i want to build a zigbee device using an ultrasonic sensor like  JSN-SR04T-2.0 - would this be possible?

Greets,
Stefan

bojanpotocnik, 2021-05-04:
Please keep issues here related to Flower project and its firmware - which _issue_ of the latest firmware does this question address?

Anyway, answer to your question: check [Zigbee Configurable Firmware](https://ptvo.info/zigbee-configurable-firmware-features/), you can do almost anything.

Thread 24 (2021-05-05):

JLCPcb order with soldering elements problem

GSternik, 2021-05-05:
Hi, when I uploaded gerber file and bom file they require to add CPL file. Where I can find this file?

nurikk, 2021-05-11:
[In this Russian article ](https://modkam.ru/?p=1832)

Closed 2021-05-11.

Thread 25 (2021-05-08):

Unable to join v3 board to Conbee II (deconz) network

cburghardt, 2021-05-08:
I have ordered an assembled v3 board and added the BME as breakout board. Then I flashed the 2.0.8 version.
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

Now I am trying to add the sensor to my Zigbee network but it doesn't recognize the device. I am using a Conbee II stick so a Deconz software. The video shows the reaction from the sensor.

https://user-images.githubusercontent.com/839480/117554307-1cfe4000-b057-11eb-85ab-8d2b2dac9331.mp4

cburghardt, 2021-05-13:
Got it, will switch to zigbee2mqtt

Closed 2021-05-13.

Thread 26 (2021-05-17):

is it possible to use "Capacitive soil moisture sensor v1.2" with e18-ms1-pcb and this code?

errdos, 2021-05-17:
more of a question than an issue.
i was wondering if its possible (and how) to use the firmware with e18-ms1-pcb and a "Capacitive soil moisture sensor" with 3 pin
connectors.

looking over the board it seems very very similar to the sensor that i already have (Capacitive soil moisture sensor v1.2).

bojanpotocnik, 2021-05-18:
You are correct, the shape and operation principle is basically the same as for other capacitive soil moisture sensors. As written in the [README.md](https://github.com/diyruz/flower#user-content-version-1):
> The circuit for measuring soil moisture is typical for this kind of device and, in principle, repeats the Chinese sensor, with the only difference that Jager increased the frequency of the generator to 2 MHz.

If you compare [V1 schematic](https://github.com/diyruz/flower/blob/master/images/DIYRuZ_Flower_4.png) with you v1.2 sensor, you will see that the upper left part is already present on your sensor. You can try to connect analog output of your sensor to pin P0.4.

eitanV81, 2021-05-18:
first of all thanks for the info and help!

so if i read the schema correctly i can (as you mentioned) connect p0.4 to analog output and p1.1 to VDD? (guessing from the schema of version1)
i assume that the new version P1.4 is used to create up to 3 MHZ signal instead of the chip (which already exists in my sensor)?
so the questions i am left with are:
1. is the analog input of the board support up to 3.3v (i assume it does)
2. does the VDD power still works (and enough ) using P1.1
3. or should i simply jump over the whole chip of my sensor and try to implement what is done in V2.. but i find it a bit complicated to understand what does exists in my sensor and what doesn't.

do you think it's worth pursuing?
i will also try to read on Zigbee Configurable Firmware but it seems that it doesnt support sleep :( so i wont be able to use it on battery.

errdos, 2021-05-18:
first of all thanks for the info and help!

so if i read the schema correctly i can (as you mentioned) connect p0.4 to analog output and p1.1 to VDD? (guessing from the schema of version1)
i assume that the new version P1.4 is used to create up to 3 MHZ signal instead of the chip (which already exists in my sensor)?
so the questions i am left with are:
1. is the analog input of the board support up to 3.3v (i assume it does)
2. does the VDD power still works (and enough ) using P1.1
3. or should i simply jump over the whole chip of my sensor and try to implement what is done in V2.. but i find it a bit complicated to understand what does exists in my sensor and what doesn't.

do you think it's worth pursuing?
i will also try to read on Zigbee Configurable Firmware but it seems that it doesnt support sleep :( so i wont be able to use it on battery.

bojanpotocnik, 2021-05-19:
> i can (as you mentioned) connect p0.4 to analog output and p1.1 to VDD? (guessing from the schema of version1)

Yes, that should work. P1.1 is used instead of V3.3 to decrease power consumption - so the sensor is powered (3.3V from P1.1) only for short time.

[CC2530 datasheet](https://www.ti.com/lit/ds/symlink/cc2530.pdf) pages 11, 18.

> 1. is the analog input of the board support up to 3.3v (i assume it does)

Yes, input voltage is 0-VDD V, where VDD is voltage on AVDD5 pin.

> 2. does the VDD power still works (and enough ) using P1.1

```plain
| P1_1 | 9 | Digital I/O | Port 1.1 – 20-mA drive capability
```
Yes, P1.1 is one of the 2 IO pins capable of 20 mA. Your sensor shall consume much less, but you can measure to be sure.

> 3. or should i simply jump over the whole chip of my sensor and try to implement what is done in V2.. but i find it a bit complicated to understand what does exists in my sensor and what doesn't.

That would work. You can compare V1 schematic with your sensor, then V1 with V2 to see changes. Power consumption would be lower for sure, because you don't need to power 555 on your sensor. You would connect P1.4 to where pin 3 of 555 chip goes on your sensor, but first make sure that non-powered OUT pin of existing 555 does not consume anything.

Thread 27 (2021-06-12):

Проблема с датчиком DS18B20

gumileeev, 2021-06-12:
Для v3 мною были закуплены датчики DS18B20 по этой ссылке: https://aliexpress.ru/item/1783091649.html
После их установки - я получаю только 2 значения с датчика температуры: 0 и 25 градусов, значения рандомные, ни от чего не зависят. Я предполагаю, что датчики могли быть неоригинальные. Прошивку использую 2.08. Пробовал 2.05, но ситуация не меняется. В отзывах пишут о том, что должно быть какое то "паразитное" питание. Подскажите, есть ли возможность исправить эту проблему?

bojanpotocnik, 2021-06-14:
Similar happened to me - one batch of cheap sensors (20 pcs) from AliExpress always show exactly 25.0°C. You have [counterfeit DS18B20](https://github.com/cpetrich/counterfeit_DS18B20) sensors... Read reviews before buying, hope for some luck (I bought many OK DS18B20 from eBay and AliExpress in the past), or buy from legit suppliers (LCSC, Farnell, DigiKey, RS, Mouser, local electronic components stores, ...).

gumileeev, 2021-06-17:
> Similar happened to me - one batch of cheap sensors (20 pcs) from AliExpress always show exactly 25.0°C. You have [counterfeit DS18B20](https://github.com/cpetrich/counterfeit_DS18B20) sensors... Read reviews before buying, hope for some luck (I bought many OK DS18B20 from eBay and AliExpress in the past), or buy from legit suppliers (LCSC, Farnell, DigiKey, RS, Mouser, local electronic components stores, ...).

Спешу сообщить, что уважаемый Jager поделился со мной другой версией прошивки 2.0.8, к ней прилагался скрин, возможно по нему вы сможете определить, какая именно это версия файла. С ней все мои датчики исправно заработали и больше не показывают 0 и 25. Вдруг вы сочтете внести такое исправление в основной релиз :)  Спасибо!
[DIYRuZ_Flower.zip](https://github.com/diyruz/flower/files/6671950/DIYRuZ_Flower.zip)
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

bojanpotocnik, 2021-06-18:
Nice! :open_mouth:  Maybe my "dead" sensors will also start working.

> Suddenly you will consider making such a fix in the main release :)

I am not sure if I understand this (can't read cyrillic) properly... Did you mean to say that @nurikk will push and merge the commit/fix soon and make version 2.0.9? I personally cannot do it, I don't know what the fix is.

gumileeev, 2021-06-25:
> Nice! 😮 Maybe my "dead" sensors will also start working.

У вас получилось? Сенсор заработал?

> Did you mean to say that @nurikk will push and merge the commit/fix soon and make version 2.0.9?

Да, я бы хотел, что бы внесли официальное исправление. Это не в моей компетенции.

gumileeev, 2021-07-05:
Сенсор температуры отлично отправляет данные на этой прошивке. Однако за 4 дня полностью расходует заряд 2хААА батареек. В следствии чего избавился от этих не оригинальных датчиков температуры и накатил оригинальную прошивку. Запрос закрываю.

Closed 2021-07-05.

Thread 28 (2021-06-24):

Help writing groovy device driver

AutomateMyLifee, 2021-06-24:
I'm trying to get this sensor working with the Smartthings/Hubitat platform. It paired easily to the hub, but I had to create my own driver. So far I have the sensors accurately reporting battery and values from BME280 (temp, humid, and pressure), but I can't get the sensor to send the correct values for the soil moisture. These are the commands I sent to configure the device so it sends data.
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
But the soil cluster (0408) is sending the attribute 0201 instead of 0000. I had it reporting the soil moisture at one point, but I must  be sending the wrong config because now it stopped sending the correct value. I checked all source code best I could, but I don't really have experience with ZigBee firmware. What am I doing wrong with the config command?
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

bojanpotocnik, 2021-06-28:
I think the problem may actually be in the SmartThings/Hubitat.

All working clusters IDs [are defines from `zcl.h`](https://github.com/diyruz/flower/blob/master/Source/zcl_app.h#L41-L47), that is standard [ZCL General Clusters](http://software-dl.ti.com/simplelink/esd/simplelink_cc13x2_26x2_sdk/4.20.00.35/exports/docs/zigbee/doxygen/zigbee/html/group___z_c_l___g_e_n_e_r_a_l___c_l_u_s_t_e_r_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) or [ZCL Measurement & Sensing Clusters](http://software-dl.ti.com/simplelink/esd/simplelink_cc13x2_26x2_sdk/4.20.00.35/exports/docs/zigbee/doxygen/zigbee/html/group___z_c_l___m_s___c_l_u_s_t_e_r___i_d_s.ht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) (there is also a reference to the same ZCL standard on the [SmartThings page](https://docs.smartthings.com/en/latest/device-type-developers-guide/zigbee-primer.html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)).

`SOIL_HUMIDITY` cluster is not part of the [ZCL v7 specification](https://zigbeealliance.org/wp-content/uploads/2019/12/07-5123-06-zigbee-cluster-library-specification.pdf), that is why its ID is the only one [manually typed](https://github.com/diyruz/flower/blob/master/Source/zcl_app.h#L45) in source, instead of using define from `zcl.h`. Consequently it is also not present within [SmartThings Capabilities](https://docs.smartthings.com/en/latest/capabilities-reference.html#capabilities-taxonomy).

[ZigBee Cluster Library Specification](https://zigbeealliance.org/wp-content/uploads/2019/12/07-5123-06-zigbee-cluster-library-specification.pdf):
- For BME, _**0x0405** Relative Humidity Measurement - **0x0000** MeasuredValue_ (**4.7.2.2.1**) is used
- For soil moisture, nonexistent cluster _**0x0408** Soil Humidity Measurement? - Relative Humidity in % - **0x0200-0xFFFE** Vendor defined_ (**3.14.11.19.1.2**) is used

So the behaviour is correct and per-specs: because Soil Humidity is not yet supported in the Zigbee standard, author chose vendor defined Relative Humidity type 0x0201 out of range 0x0200-0xFFFE for vendor defined types.

bojanpotocnik, 2021-07-24:
@AutomateMyLifee try with the new release [2.1.0](https://github.com/diyruz/flower/releases/tag/2.1.0), if there will be any difference.

AutomateMyLifee, 2021-07-26:
I haven't found any more success. The new firmware give the same behavior, except there is some warning about the endpoint 2. So you are saying that the value from cluster 0x0408 and attribute 0x0201 should give soil humidity? I tried putting the sensor in water and in air and this value stays basically the same. Isn't it in the [source code](https://github.com/diyruz/flower/blob/e4cb8726fa5d75605b4298160d12e1dfa0b26df1/Source/zcl_app.c#L273) that the attribute should MeasuredValue, which is 0x0000?

Thread 29 (2021-07-03):

Source code issue

MatthijsThijssen, 2021-07-03:
Hi all,

First of all: I would like to thank all of you working on this nice project!

To implement it in my environment i would like to make some changes. Before i can do this i try to compile the actual source version but i have some issues...

First of all: I build the developemt environment exactly as described. So far so good. I can compile the source code but for some reasons i have the following issues:

- The output Flower_CHDTECH.HEX file is 536KB in relation to the posted DIYRuZ_Flower.HEX, which is 455 KB in size...
- The consumed power of the generated Flower_CHDTECH.HEX is much higher which makes that battery period is much shorter.
- The LED is nearly not visible, this is in the org DIYRuZ_Flower perfect, so it is an  firmware issue...

Maybe there are more different things, but this is what i see after compiling the posted source (without changing any code).

Are there "Things to know and define" in the development environment before compile?
Is the source outdated in relation to the available HEX file?

Please let me know, i like the porject but i need to have it current before i can start to implement it and work on it...

Thanks in advance!
Matthijs

bojanpotocnik, 2021-07-16:
> Things changed, you need IAR version 10.30...

@MatthijsThijssen, I suggest you recover your original comment and add this as and EDIT: below.

I think we will resolve this eventually. Personally I wouldn't be happy with myself providing "just use older version of the tool" as a requirement or solution. Things do change, but in case of compilers usually for the better. I have IAR 10.40.1 installed, have compiled this repo successfully, but haven't had a time to test and debug it yet. It seems like also @nurikk cannot dedicate much time to this project, but eventually someone will find a fix for newer version and this issue could be properly closed. Maybe you can change the title for something more related, e.g. "Compiling using IAR version higher than 10.30".

Relates to #10.

nurikk, 2021-07-16:
Nothing has been changed in zstack 3.0.2 since 2007... So sticking to old version or IAR is a good idea.

Here is download link
http://netstorage.iar.com/SuppDB/Protected/PRODUPD/013455/EW8051-10301-Autorun.exe

TPertenava, 2021-07-16:
Hi,
Trying to get hex compiled from source to move on to fixing clusters issue for DeCONZ integration.
But unfortunately output hex I am getting after compilation seems to be broken. The same device works fine when I use precompiled hex, but my own version result in solid LED after reflashing and blinking LED after the button press. No pairing (
There were some warnings when compiling, anyone has a clue what could be the issue?
`Warning[Pe047]: incompatible redefinition of macro "INP" (declared at line 10 of "C:\ C:\Texas Instruments\Z-Stack 3.0.2\Components\osal\include\comdef.h 63
Texas Instruments\Z-Stack 3.0.2\Projects\zstack\HomeAutomation\Flower\zstack-lib\
utils.h") `

`Warning[Pe128]: loop is not reachable C:\Texas Instruments\Z-Stack 3.0.2\Components\hal\common\hal_assert.c 245 `

`Warning[w6]: Type conflict for external/entry "GetBindingTableEntry", in module APS
against external/entry in module BindingTable; function return types are different;
class/struct/union types have different sizes`

`Warning[w6]: Type conflict for external/entry "bindFind", in module APS against
external/entry in module BindingTable; function return types are different;
class/struct/union types have different sizes `

`Warning[w6]: Type conflict for external/entry "bindFindExisting", in module APS against
external/entry in module BindingTable; function return types are different;
class/struct/union types have different sizes `

`Warning[w6]: Type conflict for external/entry "bindIsClusterIDinList", in module APS
against external/entry in module BindingTable; function types differ in parameter 1;
class/struct/union types have different sizes `

`Warning[w6]: Type conflict for external/entry "bindRemoveClusterIdFromList", in
module APS against external/entry in module BindingTable; function types differ in
parameter 1; class/struct/union types have different sizes `

`Warning[w6]: Type conflict for external/entry "bindRemoveEntry", in module APS
against external/entry in module BindingTable; function types differ in parameter 1;
class/struct/union types have different sizes `

`Warning[w6]: Type conflict for external/entry "pbindAddEntry", in module APS against
external/entry in module BindingTable; function return types are different;
class/struct/union types have different sizes `

nurikk, 2021-07-17:
Hello, this warnings absolutely harmless. Kindly refer to this manual to setup your development environment https://zigdevwiki.github.io/Begin/IAR_install.html

bojanpotocnik, 2021-07-17:
@nurikk is this page lately 404 only for me?
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

nurikk, 2021-07-17:
My bad https://zigdevwiki.github.io/Begin/IAR_install/

TPertenava, 2021-07-17:
> Hello, this warnings absolutely harmless. Kindly refer to this manual to setup your development environment https://zigdevwiki.github.io/Begin/IAR_install.html

OK, that means it should work but it doesn't, just the same solid LED after flashing to the device (or rebooting it) and blinking LED when pressing the button. I've compared precompiled hex files from this repo with file compiled by me and it is a lot different (it has the same size but contents have just a few similar raws, all in "red" when trying to diff it...
Reinstalled IAR environment 10.30 from scratch and also cloned repo once again with no avail.
Also tried to glance into Project options, seems like it has everything preconfigured as expected (some custom options for Compiler, Linker, etc...)
Any idea what could be my issue?

nurikk, 2021-07-18:
Have you applied SDK patch? (Mentioned on wiki page)

Apply SDK patch
After installing the IAR, you should apply the patch to correctly compile the sources.

You can find the patch [here](https://github.com/diyruz/AirSense/blob/master/0001-Fixes.patch)

How-to install:

Save 0001-Fixes.patch to your Z-stack working directory (C:\Z-Stack 3.0.2)
Open console at Z-stack working directory
Run git apply 0001-Fixes.patch

TPertenava, 2021-07-18:
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

I did, even verified manually that it was actually made changes to the z-stack files ((

nurikk, 2021-07-18:
Can you confirm that you’re using correct build profile(DIYRuZ flower)?

nurikk, 2021-07-18:
Complete rebuild all log might help me

TPertenava, 2021-07-18:
> Complete rebuild all log might help me

Hi @nurikk, really appreciate you help. I've uploaded a full build log here
https://github.com/TPertenava/flower/blob/master/firmwares/buildlog_Flower.log

nurikk, 2021-07-19:
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

You're using incorrect workspace, you need to use DiYRuZ_Flower

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

TPertenava, 2021-07-19:
> You're using incorrect workspace, you need to use DiYRuZ_Flower

Wow, it worked, thanks a bunch!!

luchuanjie, 2021-07-20:
Error executing file

error: corrupt patch at line 46

Armin-Ka, 2022-01-15:
I have the same issue as TPertenava with several Warnings.

Warning[Pe047]: incompatible redefinition of macro "INP" (declared at line 10 of "D:\ti\Z-Stack 3.0.2\Projects\zstack\HomeAutomation\flower-2.1.0\zstack-lib\utils.h") D:\ti\Z-Stack 3.0.2\Components\osal\include\comdef.h 63

Warning[Pe128]: loop is not reachable D:\ti\Z-Stack 3.0.2\Components\hal\common\hal_assert.c 245

Warning[w6]: Type conflict for external/entry "GetBindingTableEntry", in module APS against external/entry in module BindingTable; function return types are different; class/struct/union types have different sizes

Warning[w6]: Type conflict for external/entry "bindFind", in module APS against external/entry in module BindingTable; function return types are different; class/struct/union types have different sizes

Warning[w6]: Type conflict for external/entry "bindFindExisting", in module APS against external/entry in module BindingTable; function return types are different; class/struct/union types have different sizes

Warning[w6]: Type conflict for external/entry "bindIsClusterIDinList", in module APS against external/entry in module BindingTable; function types differ in parameter 1; class/struct/union types have different sizes

Warning[w6]: Type conflict for external/entry "bindRemoveClusterIdFromList", in module APS against external/entry in module BindingTable; function types differ in parameter 1; class/struct/union types have different sizes

Warning[w6]: Type conflict for external/entry "bindRemoveEntry", in module APS against external/entry in module BindingTable; function types differ in parameter 1; class/struct/union types have different sizes

Warning[w6]: Type conflict for external/entry "pbindAddEntry", in module APS against external/entry in module BindingTable; function return types are different; class/struct/union types have different sizes

The Fix is applied an modifictions in the two Files are Done. I use the right Workspace.

Thread 30 (2021-07-04):

Light sensor

madman2143, 2021-07-04:
Thank you for this great project.

What sensor is utilized for light level sensing by design? There are several parts available to order, which one is recommended?

bojanpotocnik, 2021-07-05:
@madman2143

> which one is recommended?

Probably the one used in the project - on schematics [v1](https://modkam.ru/?p=1671), [v2](https://modkam.ru/?p=1700) and [v3](https://modkam.ru/?p=1832) there is [3528-PTSM D3528](https://lcsc.com/product-detail/Ambient-Light-Sensors_Shenzhen-Jing-Chuang-He-Li-Tech-3528-PTSM-D3528_C242256.html). Or some [alternatives](https://github.com/diyruz/flower/issues/19#issuecomment-864598560) mentioned in #19.

_Please close the issue if this answered your question._

madman2143, 2021-07-05:
Thank you!

Closed 2021-07-05.

Thread 32 (2021-07-24):

Dual layer capacitive sensor in PCB better?

nielsfaber, 2021-07-24:
I see that the V2 PCB layout uses copper plates on the top layer for capacitive measurement.
I would expect that copying the same copper plates also to the bottom layer will increase the capacitive coupling by approx. 2 times.
Hence the signal-noise ratio of the measurement becomes much better.
Is there any specific reason why the single layer is used instead?
Am I overlooking something?

nurikk, 2021-08-05:
It’s good enough to use current traces, moreover changing tracks will require recalibration process (quite sophisticated and undocumented)

Thread 33 (2021-07-25):

Flashing new firmware

habitoti, 2021-07-25:
Now that the firmware was fixed so that the sensor can potentially work with a Cobee/DeConz setup: how would I flash it to the device? Seems not to support OTAUs…

nurikk, 2021-07-26:
You can follow this manual

https://www.zigbee2mqtt.io/information/flashing_the_cc2531.html

habitoti, 2021-07-26:
Ok, so much for the programming equipment. Ordered, thanks!
Now I am not a total dummy wrt HW and SW, but probably at least half of it 😬

Do you also have some instructions at hand where to connect the debugger cables to? The sensor has no connector plugs whatsoever (on the other side there's a piggy backed battery holder), so I probably need to solder at least temporarily some cables to VCC/RST/P2.2/P2.1/GND, right? But tbh, I have no clue...

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

guny74, 2021-07-30:
I also have a CCDebugger now, but need to know how to wriring to the sensor.

habitoti, 2021-07-30:
Found this site: https://ptvo.info/how-to-select-and-flash-cc2530-144/

Received my CCDebugger today, so will try this weekend...

guny74, 2021-07-30:
Ok, I found something, but not my language https://kvshome.ru/?p=2706  I will try via the pictures...

habitoti, 2021-07-30:
See link above, it shows exactly how how to wire it...

guny74, 2021-07-30:
Flashing successful

Thx

Thread 34 (2021-07-25):

How to upgrade Firmware e.g. with CC Loader or something else ?

guny74, 2021-07-25:
Hello,

is there a guide with picture how to upgarde the firmware ?

Thx

nurikk, 2021-07-26:
You can follow this manual

https://www.zigbee2mqtt.io/information/flashing_the_cc2531.html

guny74, 2021-07-26:
Hello,

Sorry I wann to Upgrade the flowrr moisture sensor not the Controller...

nurikk, 2021-07-26:
Instructions are the same

guny74, 2021-07-26:
Ok, I will try...

thank you

Thread 35 (2021-08-03):

Does not work with ZHA (Zigbee Home Assistant)

qneverless, 2021-08-03:
Hi,

I have tested the device and it works correctly with Zigbee2MQTT, but not ZHA.
The device can be added to ZHA:
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
Unfortunately, no sensor data is recognized or displayed by Home Assistant.
Other sensors and lights are working fine, so I think there might be some quirk or non-standard behavior that needs patching.

Please help with finding the root cause of this issue.
I have an embedded programming background, but I am not sufficiently familiar with Zigbee to quickly jump into the problem.

MatthijsThijssen, 2021-08-03:
Dear sender,

I will be out of the office starting 03 August through 16 August returning. During this period i have limited access to my email. I will respond to your emails as soon as possible upon my return.
You can also send your message to ***@***.*** so one of my colleague can follow up.
Thank you for your message

nurikk, 2021-08-04:
Hello, try to use latest version 2.1.0

visstro, 2021-08-04:
I got the assembled and "ready to use" device. I guess that I will need CC debugger for flashing? Or is OTA possible?

nurikk, 2021-08-05:
Yes, you need a cc debugger. You can find flashing instructions and some support here https://github.com/diyruz/flower/issues/33

pooyashahidi, 2021-08-09:
running the latest version (2.1.0)
I think I have the same problem. I am able to add the device to ZHA but it only shows the following entities:
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

The illuminance value looks wrong battery started at 128% and is now 32% which also does not make sense.

If I'm not mistaken the humidity, pressure and temperature entities should come from the bme280 sensor that I do not need and did not install and another temperature is for the other optional sensor. so am I correct to assume that the whole soil sensing thing is missing?

Any help is highly appreciated :)

madman2143, 2021-08-19:
I have the same issue. The soil moisture is not reported when using ZHA.

Thread 36 (2021-09-11):

values do not update

Bartekn86, 2021-09-11:
hi,
after update fw to latest ( sensor with crxx32 battery) values do not want do update mqtt works but sensor send the same values all the time

Bartekn86, 2021-09-11:
never mind, problem was usb stick firmware

Closed 2021-09-19.

Thread 38 (2021-09-17):

Zigbee 3.0 firmware (on CC2530) for EFEKTA Zigbee Plant Watering Sensor?

Gamester17, 2021-09-17:
Please consider building and releasing a Z-Stack 3.0.x (Zigbee 3.0) firmware for CC2530 based EFEKTA Zigbee Plant Watering Sensor.

FYI, kirovilya from DIYRUZ community have backported Z-Stack 3.0 (with Zigbee 3.0) support to CC2530 as a proof-of-concept:

* https://github.com/diyruz/diyruz_rt
  * https://github.com/diyruz/diyruz_rt/releases
    * https://zigbee.blakadder.com/DIYRuZ_RT.html

kirovilya tested Z-Stack 3.0.x firmware with DS18B20 on Sonoff BASICZBR3 and also made config to be a Zigbee 3.0 router device:

* https://habr.com/ru/company/iobroker/blog/495926/ (written in Russian so used Google Translate)

For a battery-operated device you would of course want to use a Zigbee end device config and not a Zigbee router config.

More information on Z-Stack 3.0 for CC253x (CC2530 and CC2531) here:

https://www.bestov.io/blog/zigbee-3-part-1-getting-started-with-cc2530

https://www.cnx-software.com/2020/05/25/zigbee-firmware-news-ti-z-stack-3-0-zigbee-for-cc2530-ptvo-zigbee-fw-configuration-tool/

https://github.com/Koenkk/zigbee2mqtt/issues/1445

Gamester17, 2021-09-17:
By the way, it looks like Tech4You / TrimVa ZeeFlora DIY Soils Moisture ZigBee sensor is also based DIYRuZ Flower and provides/provided a Zigbee 3.0 firmware based on Z-stack 3.0.2 for Ebyte E18-MS1-PCB module based on CC2530

https://zigbee.blakadder.com/Zeeflora.html

https://github.com/TrimVa/ZeeFlora

https://github.com/TrimVa/ZeeFlora/commits/main

Perhaps @TrimVa (S. Girard & P. Schuler) would be willing to confirm or even share their Z-stack 3.0 firmware code?

PS: I also posted this request/question to smartboxchannel / EFEKTA here -> https://github.com/diyruz/flower/issues/38

Bartekn86, 2021-09-19:
+1

shajek, 2023-03-23:
Hello,

anyone try some of the zigbee 3.0 frimwares from another sensor on diyruz v3 hardware ?

Thread 39 (2021-10-01):

Add photoelectric/photoresistor light meter sensor (similar to Xiaomi Mi Flora)

Hedda, 2021-10-01:
Please consider adding a photoelectric/photoresistor light meter sensor for measuring plant light levels in order to help determen growth conditions to the hardware design and firmware.

Examples of Arduino compatible Light Meter sensors are BH1750

Hedda, 2021-10-21:
These GUVA-S12SD UV sunlight intensity sensor modules look otherwise to be relatively inexpensive:

https://www.aliexpress.com/w/wholesale-sunlight-intensity-sensor.html

https://www.aliexpress.com/wholesale?catId=0&initiative_id=SB_20211021025302&SearchText=GUVA-S12SD

Thread 40 (2021-10-01):

Add a temperature and humidity (AM2302, DHT11 or DHT22) sensor

Hedda, 2021-10-01:
Request add a temperature and humidity () sensor to the hardware design and firmware.

Examples of an Arduino compatible temperature and humidity sensors are  AM2302, DHT11 or DHT22

Thread 41 (2021-10-17):

firmware optimalization  few the same messages

Bartekn86, 2021-10-17:
Oct 17 20:52:00 raspberrypi npm[13682]: Zigbee2MQTT:info  2021-10-17 20:52:00: MQTT publish: topic 'zigbee2mqtt/kulkas', payload '{"battery":8,"humidity":66.64,"illuminance":715,"illuminance_lux":1,"linkquality":126,"pressure":998.5,"soil_moisture":100,"temperature_bme":24.07,"temperature_ds":25,"voltage":2500}'
Oct 17 20:52:00 raspberrypi npm[13682]: Zigbee2MQTT:info  2021-10-17 20:52:00: MQTT publish: topic 'zigbee2mqtt/kulkas', payload '{"battery":11,"humidity":66.64,"illuminance":715,"illuminance_lux":1,"linkquality":126,"pressure":998.5,"soil_moisture":100,"temperature_bme":24.07,"temperature_ds":25,"voltage":2500}'
Oct 17 20:52:00 raspberrypi npm[13682]: Zigbee2MQTT:info  2021-10-17 20:52:00: MQTT publish: topic 'zigbee2mqtt/kulkas', payload '{"battery":11,"humidity":66.64,"illuminance":715,"illuminance_lux":1,"linkquality":126,"pressure":998.5,"soil_moisture":100,"temperature_bme":24.07,"temperature_ds":25,"voltage":2500}'
Oct 17 20:52:00 raspberrypi npm[13682]: Zigbee2MQTT:info  2021-10-17 20:52:00: MQTT publish: topic 'zigbee2mqtt/kulkas', payload '{"battery":11,"humidity":66.64,"illuminance":715,"illuminance_lux":1,"linkquality":123,"pressure":998.5,"soil_moisture":100,"temperature_bme":23.98,"temperature_ds":25,"voltage":2500}'
Oct 17 20:52:00 raspberrypi npm[13682]: Zigbee2MQTT:info  2021-10-17 20:52:00: MQTT publish: topic 'zigbee2mqtt/kulkas', payload '{"battery":11,"humidity":66.67,"illuminance":715,"illuminance_lux":1,"linkquality":126,"pressure":998.5,"soil_moisture":100,"temperature_bme":23.98,"temperature_ds":25,"voltage":2500}'
Oct 17 20:52:00 raspberrypi npm[13682]: Zigbee2MQTT:info  2021-10-17 20:52:00: MQTT publish: topic 'zigbee2mqtt/kulkas', payload '{"battery":11,"humidity":66.67,"illuminance":715,"illuminance_lux":1,"linkquality":126,"pressure":998.5,"soil_moisture":100,"temperature_bme":23.98,"temperature_ds":25,"voltage":2500}'
Oct 17 20:52:00 raspberrypi npm[13682]: Zigbee2MQTT:info  2021-10-17 20:52:00: MQTT publish: topic 'zigbee2mqtt/kulkas', payload '{"battery":11,"humidity":66.67,"illuminance":715,"illuminance_lux":1,"linkquality":126,"pressure":998.5,"soil_moisture":100,"temperature_bme":23.98,"temperature_ds":25,"voltage":2500}'

there is a lot of the same message.  is it nesesery to duplicate it ?

Thread 43 (2021-10-21):

Request redesign for newer Texas Instruments multi-protocol module like CC2652

Hedda, 2021-10-21:
Have you considered replacing CC2530 with new TI MCU like CC2652 or similar?

Should in theory make the battery last longer as well as make for more future-proof hardware with the potential of perhaps not only using Zigbee 3.0 but also even using Thread, Matter (Project CHIP), and/or Bluetooth via multi-protocol support as well.

Maybe use one of the newer CC2652R or CC2652RB multi-protocol modules from RF-Star or Ebyte?

https://www.szrfstar.com/product/189-en.html

https://www.szrfstar.com/product/list-196-en.html

https://www.ebyte.com/en/product-view-news.html?id=1481

https://www.ebyte.com

bojanpotocnik, 2021-11-29:
This would also make https://github.com/diyruz/flower/issues/20 possible

Hedda, 2022-02-08:
@nurikk Have you given any more thought to @diyruz flower sensor redesign with a CC2652 radio module?

For your information, there is much discussion about it and its derivative Zigbee flower/plant sensors here:

https://community.home-assistant.io/t/zigbee-flower-sensors-for-soil-moisture-light-temperature-humidity/272803

The "efekta" variants by smartboxchannel has epsecially become popular but it too uses the an old CC2530:

https://github.com/smartboxchannel/Plant-Watering-Sensor-Zigbee

bojanpotocnik, 2022-02-09:
What about EFR32MG2x? I'm lately working with Silabs chips and thinking about doing this with MG2x series...

Thread 44 (2021-11-07):

Failing to fully pair in zigbee2mqtt

robertalexa, 2021-11-07:
Hi @nurikk

I have 20 devices based on the V3 specs, built by JLC PCB, all of them running AAA batteries, without the DS or BCM sensors. All devices have been flashed to 2.1.0 version (latest as of now).

I have tried pairing the devices to zigbee2mqtt, and every single time something fails. The devices get paired "successfully", show us supported devices, but the binds fail, or if the binds succeed, the reporting fails, The most I have managed to get them so far was to have battery reporting (though it started with 128%).

I get no values for soil_humidity or illuminance. But like i said, the reporting fails, so I am not surprised.

I have tried pairing the devices in a random location, then close to a router device, then close to the coordinator, same result. After removing the device (force) from z2m, I have always restarted z2m.

So I am lost here. Would you be able to help, or do I basically have 20 useless devices now?

Thanks in advance

LE: I am running the latest version of z2m, my coordinator is the electrolama zzh, my network consists of 39 zigbee devices (some end devices, some acting as routers too), so my mesh should be strong and healthy

mathieuchurlet, 2021-11-07:
I have the same problem.
Sometimes, the device get paired successfully, and for 5 devices, i have all the values, but for others, interview ok, but no value are sent.

robertalexa, 2021-11-07:
I have just tried to pair one to my testing environment on a CC2531 and the devices paired and configured successfully. At least I know there is no problem with the device.

Here are screenshots of some info;

Binds
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

Reporting
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

Exposes
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

I will continue digging, it might be just poor quality signal, or interference i guess, but that makes me wonder what the reliability of the device is

nordeep, 2021-11-10:
Had the same issue. In my case some of tricky settings of Zigbee2MQTT gave the result:
Settings - Serial - Adapter - force to zstack
Settings - Serial - Adapter - Disable led.

I'm using cheap CC2531 USB Coordinator. Flashed by CC2531_DEFAULT_20201127 firmware.
https://www.zigbee2mqtt.io/guide/adapters/flashing/alternative_flashing_methods.html

robertalexa, 2021-11-10:
I have done some more testing yesterday with my testing environment, usb in laptop, device next to laptop. All 20 devices paired and configured successfully.

So the issue must just be distance, I will try to get them onto my main network and see what i get

mathieuchurlet, 2021-11-11:
Pairing done with the new sonoff dongle, with a cheap cc2530 with the latest firmware and with a diy CC2538... Nothing with the value.
The pairing is ok, but the device doesn't send anything...

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

mathieuchurlet, 2021-11-11:
Same issue if I try to pair near the coordinator or the router.

robertalexa, 2021-11-15:
So I have finally found the time to play with them further.

The devices paired and configured successfully to my main network and have connected via a router. So not sure what happened there at first. Maybe just a bad connection or interference

Closed 2021-11-15.

Thread 45 (2021-11-15):

A few questions please

robertalexa, 2021-11-15:
Hi @nurikk and thanks for your work.

Got a few questions and I am unable to find a clear answer anywhere, not even looking at the firmware code.

1. What is the battery percentage scale used? 0 to 100 or 0 to 200 as per ZCL standard. I am asking this because in my setup with 2xAAA the device is reporting 2.7V, 36 battery percentage which turn into 18% in z2m. If the scale is 0 to 100 i can put in a PR and get this fixed in z2m. Even so, my batteries are fully charged, so even 36% sounds veeery low. And with that I would expect to have a better conversion, or 2 versions of the firmware for the 2 types of batteries. Looking at the code I would have expected to see the battery low threshold set to sth, but i can't find it.

2. What is the range of illuminance? Like min and max values, and what is the conversion to lux. Converting the current values to lux in z2m give a result that is waaay too low. So if I know what the raw values could be, i can try to map it to correct lux readings in a PR in z2m. Here is a screenshot of my device for reference

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

3. Can conductivity be measured with this device, similar to the MiFlora device? If so, could anyone share some more info on this?

Many thanks

robertalexa, 2021-11-29:
Can anyone point me to somewhere else where I can ask these questions?

Alternatively, I might just sell my devices and try to recoup some of the money i spent building them. If anyone is interested, send me an email (check my profile)

Thread 46 (2022-01-14):

Where does MQTT Data temperature_bme suffix _bme comes from

Armin-Ka, 2022-01-14:
Hello,
after hours of searching I will not find the Software Part where the _bme suffix for the BME 280 Temperature Sensor will be added.
I use this Software to build a own Sensor Board with Differrent Sensor. I know , maybe i have to define several Endpoint e.g. for Temperature Values.
I hope i will be able to Label the values of BME Senor wit humidity_bme , temperature_bme , pressure_bme.
Thanks in Advance
Armin

Armin-Ka, 2022-01-21:
Ok, i find out that this suffix will come from the Converter

Closed 2022-01-21.

Thread 47 (2022-01-26):

Debbug to I/O Terminal of IAR will show wrong numbers ; String is OK

Armin-Ka, 2022-01-26:
Hello,
i try to Debbug with the SmartRF04B Programmer/Debugger in IAR I/O Terminal. The Source is allready Prepared for this possibility.
I will See the published Strings,which will be OK. But if there are Numbers they will be wrong:
e.g. in File zcl_app.c Function zclApp_ReadSensors

    LREP("currentSensorsReadingPhase %d\r\n", currentSensorsReadingPhase);  ---> will show: currentSensorsReadingPhase 1233
I add a Line after the Above One
    printf("currentSensorsReadingPhase %d \r\n",currentSensorsReadingPhase); ----> will show: currentSensorsReadingPhase 0

I do not understand this issue. Please Help.
Thanks in advance
Armin

Thread 48 (2022-02-02):

DS 18b20 incorrect negative temperatures

indigocoin, 2022-02-02:
The DS 18b20 sensor does not correctly transmit negative temperatures. With the actual -3 it shows something -64 Celsius.

Thread 50 (2022-04-08):

Short battery life with CR2032

duhanebel, 2022-04-08:
Hi,
I've made 5 of these sensors v2 (great work btw! Thanks!!) without any extra sensor. That means I've only soldered:
- E18-MSI-PCB
- R1, R2, R3, R4
- LED1
- C1, C2
- D1
- SW1

Unfortunately I've now been running them for a few weeks and the battery voltage seems down between 2.2v and 2.8v. This is not consistent between different sensors.
What can be the reason for this? How can I find out what has gone wrong?

quark72, 2022-05-22:
I have the same problem and discovered, that the module send not only one telegram/message. It send between 4 and 6 telegrams. And i see how in the first telegram the Voltage is 3.0V and in the last telegram it drops down.
I don't understood when and why how much telegrams are repeated - sometime it send 4, sometime 6, sometime 4. Only one time i received only one telegram.
The sending takes sometime a little bit over 1sec. Is it possible that this repeatedly sending of Data the Problem is?

mattes34, 2022-06-04:
I also had the problem and built a firmware where only the soil moisture is measured. With this firmware I don't see jumps in the battery value since one day.

duhanebel, 2022-06-05:
@mattes34 would you be able to send me an hex file with your version? I can't make IAR work for me no matter how much I tried :/

mattes34, 2022-06-05:
Sure [DIYRuZ_Flower_only_soilmoisture.zip](https://github.com/diyruz/flower/files/8840707/DIYRuZ_Flower_only_soilmoisture.zip)
I think only with soil moisture measuring its possible to save energy by going back to only one cycle measurement like it was before [Do only one wakeup cycle](https://github.com/diyruz/flower/commit/340a96fce2826ec9c99b3dd8207342343cedc8ef). If I fine time I will test it in the next days

smartboxchannel, 2022-06-07:
Try this special firmware for Versions 2 and 3 sensors running on cr2032

https://github.com/smartboxchannel/Plant-Watering-Sensor-Zigbee/commit/53922d31bb3e81a2c23cdb097d4571fa9a04cc76

duhanebel, 2022-06-13:
@smartboxchannel is that a drop in replacement for the v2 I've built? I've tried to flash it but the device looks dead afterward

MatthijsThijssen, 2022-06-13:
Dear sender,

I will be out of the office starting 9 June through 27 June returning. During this period i have limited access to my email. I will respond to your emails as soon as possible upon my return.
You can also send your message to ***@***.*** so one of my colleague can follow up.
Thank you for your message

duhanebel, 2022-06-21:
@mattes34 I've tried with your firmware and while one device now works, other two refused to pair (3 LED blink every time). I'm not sure what I'm doing wrong. I've tried resetting the board by holding the button for 10seconds. On zigbee2mqtt I forced-removed the devices. My coordinator has only 10 devices connected so I don't think that is the problem (it wasn't before)

Darozas, 2022-12-12:
> @mattes34 I've tried with your firmware and while one device now works, other two refused to pair (3 LED blink every time). I'm not sure what I'm doing wrong. I've tried resetting the board by holding the button for 10seconds. On zigbee2mqtt I forced-removed the devices. My coordinator has only 10 devices connected so I don't think that is the problem (it wasn't before) **UPDATE:** Never mind - my coordinator wasn't powerful enough and now it all works!

Hi duhanebel , And how is battery life is with this firmware ? Regards

mattes34, 2022-12-12:
Hi, I think the runtime was still not good. All my sensors run out after ~30days (2h reporting time). My new Idea is to set more focus on the measurement itself, becouse the start and stop of sampling is done in the event loop (static void zclApp_ReadSensors(void)) and maybe the measurement PWM is to long on. But I don't find time to work on it. To many projects.

mattes34, 2022-12-12:
Hi, I make some changes (dirty and untested).  good luck :D

https://github.com/mattes34/flower/blob/master/firmwares/DIYRuZ_Flower_soil_moisture_only.hex

Darozas, 2022-12-12:
> Hi, I make some changes (dirty and untested). good luck :D
>
> https://github.com/mattes34/flower/blob/master/firmwares/DIYRuZ_Flower_soil_moisture_only.hex

Thanks Got it installed ill let you know results in few weeks!!!

duhanebel, 2022-12-13:
I have a strange experience: out of 20 sensors, almost half have been running for 3+ months and have still a good amount of battery. The other half dies within weeks with brand new batteries. I wonder if it might have to do with my soldering? The components are all from the same batch.
I’ll try the new firmware anyway.. worth a try!

mattes34, 2022-12-13:
Same manufacturer of the batteries  ?
@Darozas I will build a version in the next days.

What I forgot to say is that I changed the compensation in this firmware version. :-/
I make some measurements and use a curve that 0 to 100%  is from wet soil to dry. Before it was always from air to wet soil

duhanebel, 2022-12-13:
Same battery pack even. I’ve changed the firmware at one point to measure every 15m and on some sensors, the 15m firmware performs better than the 30m ones.. so I’m really unsure what’s happening.
Happy to test the firmware on the “bad ones” and see if it improves.

Darozas, 2022-12-13:
> Same manufacturer of the batteries ? @Darozas I will build a version in the next days.
>
> What I forgot to say is that I changed the compensation in this firmware version. :-/ I make some measurements and use a curve that 0 to 100% is from wet soil to dry. Before it was always from air to wet soil

Thanks Cant wait to try!!!!

duhanebel, 2023-01-05:
I've just identified one of the "bad sensors". I'll install today with a fresh batter and then we'll see what happens (with the previous firmware that board died in 40 days)

Darozas, 2023-01-05:
I have one sensor running with latest "Untested Firmware"

and battery didn't dropped yet. Its hard to tell which firmware is on sensor as both firmware's have same data

If you dont make note you can easily forget which is which

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

duhanebel, 2023-01-07:
I'm having a hard time pairing up the sensor after flashing.. my distance of zibgee2mqtt doesn't see it at all.. mmh

duhanebel, 2023-02-27:
I’ve got one device running on this firmware since jan and so far the battery seems to be steady at 3v.
Unfortunately I’m having a hard time flashing more devices: is there a particular car I need to take when reflashing? With the new firmware the device never completely configure with zigbee2mqtt and pressing the button on the pcb does nothing (the led doesn’t flash)

duhanebel, 2023-10-25:
After 6 months of testing I can conclude that... nothing. The behaviour seems to be erratic: some boards last months with one batter and then weeks with another. Some boards go on for months, while other die consistently in a few weeks. I've used the same kind of components for all 20 of them and soldered them all the same day so they should behave pretty similarly to each other.
I think this is a limitation of the CR2032: they're not consistently charged with some batches/brand lasting longer than others. This kind of device requires a battery well charged to operate (> 1.8v remaining - I can happily reuse depleted batteries with wall clocks and stuff and they'd go on for months) and I think that just makes this situation worse.
I might just swap them all for the AAA holder: that would boost capacity 5x-8x and hopefully solve the problem.

At least that's my conclusion after all these months.. let me know if you had a different experience.

AlirezaT, 2025-02-22:
I made 3 devices with all sensors and all three can't last more than a couple of months with the CR2032 Battery.  when I measure the current consumption, it is not more than 5uA DC but I'm suspicious about the 220uF Tantalum caps which are known for high leakage current. I've replaced them by a 10uF ceramic cap which is very good for leakage but its capacity will drop ~50% at half of the rated voltage. However their ESR is much better than the Tantalum caps . I'll report my finding here 🙂

AlirezaT, 2025-08-01:
@duhanebel  I had 3 sensors, i could confirm that after replacing the 220uF tantalum cap with MLCC, the battery lifetime increased. For one sensor the difference was very significant. However, still they don't last for more than 3 to 4 months.
I'm now thinking of switching the firmware to this: https://modkam.ru/2021/02/21/sensor-vlazhnosti-pochvy-zigbee-versija-3/
It is claimed to be more  efficient !

Thread 51 (2022-09-08):

Consider redesign board for CR2477 or CR2450 battery instead of CR2032?

Hedda, 2022-09-08:
Suggest re-design board with battery-clip/battery-holder/battery-retainer for CR2450 or CR2477 batteries instead of CR2032 batteries?

* CR2477 is 24 x 7.7 mm in size and usually has about 1000 mAh of capacity on average.
* CR2450 is 24 x 5.0 mm in size and usually has about 550 mAh of capacity on average.
* CR2032 is only 20 x 3.2 mm (coin cell size) but only has 200 mAh average capacity.

Alternative universal solder pads supporting fitting battery-clips/battery-holders/battery-retainers for either CR2477, CR2450, or CR2032?

I think that it might be possible to find a cleverly designed battery-clip/battery-holder/battery-retainer for CR2477 that could even be able to hold either a CR2477 or a CR2450 or even two CR2032 batteries stacked on top of each other, or what do you think?

Example:

MYOUNG MY-2477-02 (Mfr. Part # MY-2477-02 LCSC Part # C2979175)
https://lcsc.com/product-detail/Battery-Connectors_MYOUNG-MY-2477-02_C2979175.html

MYOUNG MY-2477-01 (Mfr. Part # MY-2477-01 LCSC Part # C2979173)
https://lcsc.com/product-detail/Battery-Connectors_MYOUNG-MY-2477-01_C2979173.html

MYOUNG MY-2450-01 (Mfr. Part # MY-2450-01 LCSC Part # C964845)
https://lcsc.com/product-detail/Battery-Connectors_MYOUNG-MY-2450-01_C964845.html

Reference:

https://jeelabs.org/2015/07/29/could-a-coin-cell-be-enough/index.html

 PS: I personally hate to replace batteries so really looking to get a large battery capacity and a long time between replacements.

Thread 52 (2022-09-26):

Please add v3 into the github

Drizzt321, 2022-09-26:
Found there's a [v3](https://modkam-ru.translate.goog/2021/02/21/sensor-vlazhnosti-pochvy-zigbee-versija-3/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) (via Google Translate) in the blog posts, was hoping @nurikk could upload the v3 stuff into here.

Also, for anyone who links out and downloads the v3 from the blog post, JLCPCB, as per [this comment exchange](https://modkam-ru.translate.goog/2021/02/21/sensor-vlazhnosti-pochvy-zigbee-versija-3/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), the R2 specified in the BOM, for some reason JLCPCB/LCSC was changed to be size of 0405 with 1K ohm, not a 0805 1M ohm as the BOM indicates. As per commenter Alexander, I'm trying to use component [0805W8F1004T5E ](https://lcsc.com/product-detail/Chip-Resistor-Surface-Mount_UNI-ROYAL-Uniroyal-Elec-0805W8F1004T5E_C17514.html), although haven't gotten the boards yet to verify things are working.

MatthijsThijssen, 2022-09-26:
Dear sender,

I will be out of the office starting 22 Sept through 27 Sept returning. During this period i have limited access to my email. I will respond to your emails as soon as possible upon my return.
You can also send your message to ***@***.*** so one of my colleague can follow up.
Thank you for your message

BenRoe, 2023-12-22:
Any update on this and what are the changes from v2 to v3?

Thread 53 (2022-10-12):

Notes to anyone having trouble flashing v3

Drizzt321, 2022-10-12:
Getting it flashed is really annoying, I didn't realize that the board needed to be separately powered with the battery in, no documentation anywhere I've found about flashing this, had to piece it together myself from CC Debugger manual, and then fortunately found https://github.com/smartboxchannel/Plant-Watering-Sensor-Zigbee/issues/9 which mentioned needing the battery installed.

The 1.27mm through-hole is a real PITA, would have been AWESOME to have those with standard 2.54mm/0.1" space header like for the U3 serial header for a sensor. I ended up using a [1.27mm<->2.54mm conversion board](https://smile.amazon.com/dp/B097YR29ZH), some [P50-E2 pogo pins](https://smile.amazon.com/dp/B00X7C8PGE) soldered through the 1.27mm on the conversion board held in place with some grips/helping hands, and then some [mini grabber hooks](https://smile.amazon.com/dp/B08M5GNY47) to a breadboard, and then from the breadboard some test lead/jumpers to the CC Debugger. Finally got it to light up green that way.

Flashed using [2.1.0](https://github.com/diyruz/flower/releases/tag/2.1.0) release firmware, and so far loaded up into ZHA/Home-Assistant with a bit of a challenge with the button to get it the right amount of time. Now I just need to get a reasonably rain resistant ABS case designed for me to 3D print.

Thread 54 (2022-11-25):

BME280 sensor not reporting data

Darozas, 2022-11-25:
Hi All

I have sensor mounted directly on board but get no readings

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

and it looks like some components missing on pcb for sensors?

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

recommended

DS sensor should have 4.7K resistor but its not on beard

same with BME280 no 2 resistors missing

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

Is that just me or some one else have same issue here with sensors?

Regards

nocodeman55, 2023-03-24:
Did you ever solve this? I also have a BME280 SMD directly to the board and it gives no readings

machinev1, 2024-09-14:
I was confronted with this after the first one was made. Does anyone have any new info, solutions or anything that might help since then? I have 20 PCBs ready at home and I don't want them all to go in the trash...

Thread 56 (2023-07-18):

2 parts not available

smitterer, 2023-07-18:
When trying to order v3 from jlcpcb, two parts are not available:
CL21C010CBANNNC - might be replaced by TCC0805COG1R0C500BT?
C26638 - discontinued product

Can you update the bom and CPL files to hold available parts?

Thanks!

Stephan-Fis, 2023-10-26:
C26638 like C455280
He posted the v3 on modkam and provided this picture.
https://modkam.ru/wp-content/uploads/2021/02/flower_15.png

Thread 58 (2023-10-27):

How to compile problem

derekangl, 2023-10-27:
Haw compile using instructions from " https://zigdevwiki.github.io/Begin/IAR_install/"  no SDK patch in Flower . ? how to do ?

Thread 60 (2024-09-27):

add funtion with LED indecation low power and low soil moisture

ccz999999, 2024-09-27:
Could you please add funtion with low power LED lighting and soil moisture < 20% LED flash all the time. in the case, even without read the data in homeassistant it can be easy to check the low power of battery and low soil moisture only through the LED status. thank you very much!
