diyruz/flower/Source/zcl_genericapp.h

/**************************************************************************************************
  Filename:       zcl_genericapp.h
  Revised:        $Date: 2014-06-19 08:38:22 -0700 (Thu, 19 Jun 2014) $
  Revision:       $Revision: 39101 $

  Description:    This file contains the ZigBee Cluster Library Home
                  Automation Sample Application.


  Copyright 2006-2014 Texas Instruments Incorporated. All rights reserved.

  IMPORTANT: Your use of this Software is limited to those specific rights
  granted under the terms of a software license agreement between the user
  who downloaded the software, his/her employer (which must be your employer)
  and Texas Instruments Incorporated (the "License").  You may not use this
  Software unless you agree to abide by the terms of the License. The License
  limits your use, and you acknowledge, that the Software may not be modified,
  copied or distributed unless embedded on a Texas Instruments microcontroller
  or used solely and exclusively in conjunction with a Texas Instruments radio
  frequency transceiver, which is integrated into your product.  Other than for
  the foregoing purpose, you may not use, reproduce, copy, prepare derivative
  works of, modify, distribute, perform, display or sell this Software and/or
  its documentation for any purpose.

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
  Should you have any questions regarding your right to use this Software,
  contact Texas Instruments Incorporated at www.TI.com.
**************************************************************************************************/

#ifndef ZCL_GENERICAPP_H
#define ZCL_GENERICAPP_H

#ifdef __cplusplus
extern "C" {
#endif

/*********************************************************************
 * INCLUDES
 */
#include "zcl.h"

// Added to include ZLL Target functionality
#if defined(BDB_TL_INITIATOR) || defined(BDB_TL_TARGET)
#include "bdb_tlCommissioning.h"
#include "zcl_general.h"

#endif

/*********************************************************************
 * CONSTANTS
 */
#define SAMPLESW_ENDPOINT               8

// Added to include ZLL Target functionality
#define GENERICAPP_NUM_GRPS 2

// Application Events




#define GENERICAPP_SW1_LONG_PRESS 0x0001
#define GENERICAPP_EVT_GO_TO_SLEEP 0x0002
#define GENERICAPP_END_DEVICE_REJOIN_EVT 0x0004

/*
#define GENERICAPP_EVT_2                    0x0010
#define GENERICAPP_EVT_3                    0x0020
*/

#define GENERICAPP_END_DEVICE_REJOIN_DELAY 10000

/*********************************************************************
 * MACROS
 */
/*********************************************************************
 * TYPEDEFS
 */

/*********************************************************************
 * VARIABLES
 */

// Added to include ZLL Target functionality
#if defined(BDB_TL_INITIATOR) || defined(BDB_TL_TARGET)
extern bdbTLDeviceInfo_t tlGenericApp_DeviceInfo;
#endif
extern SimpleDescriptionFormat_t zclSampleSw_SimpleDesc;
extern SimpleDescriptionFormat_t zclGenericApp_SimpleDescs[];
extern uint8 zclGenericApp_SimpleDescsCount;
extern uint8 zclGenericApp_BatteryVoltage;
extern uint8 zclGenericApp_BatteryPercentageRemainig;
extern CONST zclCommandRec_t zclGenericApp_Cmds[];

extern CONST uint8 zclCmdsArraySize;

// attribute list
extern CONST zclAttrRec_t zclGenericApp_Attrs[];
extern CONST uint8 zclGenericApp_NumAttributes;

// Identify attributes
extern uint16 zclGenericApp_IdentifyTime;
extern uint8 zclGenericApp_IdentifyCommissionState;

// GENERICAPP_TODO: Declare application specific attributes here

/*********************************************************************
 * FUNCTIONS
 */

/*
 * Initialization for the task
 */
extern void zclGenericApp_Init(byte task_id);

/*
 *  Event Process for the task
 */
extern UINT16 zclGenericApp_event_loop(byte task_id, UINT16 events);

/*
 *  Reset all writable attributes to their default values.
 */
extern void zclGenericApp_ResetAttributesToDefaultValues(void);



/*********************************************************************
 *********************************************************************/

#ifdef __cplusplus
}
#endif

#endif /* ZCL_GENERICAPP_H */
