diyruz/flower/(commit log)

2020-04-23 interrupts and zend onof report
2020-04-24 Proper interrupts on sw2
2020-04-24 Add battery pct
2020-04-25 fix interrupts on sw2
2020-05-02 Buttons reorder
2020-05-03 Hall refactor
2020-05-03 Fix devboard uart ussues
    [preinclude.h]
2020-05-04 implement FREEPAD_8 and FREEPAD_12 pin mapping
2020-05-04 Immidiate reset in not in network
    [zcl_freepadapp.c]
2020-05-04 Fixes
    send battery after 10 seconds
    fix send hold, release
    don't send release after clicks
    reset from any key if device not in network
    [zcl_freepadapp.c, zcl_freepadapp.h]
2020-05-04 Replace level controll move by step
    [zcl_freepadapp.c, zcl_freepadapp.h]
2020-05-05 Fix resets during join
    [zcl_freepadapp.c]
2020-05-05 Increase bindings table size
    [preinclude.h]
2020-05-05 Send battery after timeout
2020-05-05 Remove binding comision mode
    [zcl_freepadapp.c]
2020-05-05 Add steering mode
2020-05-06 Rejoin with FN reset
    [zcl_freepadapp.c]
2020-05-07 Proper power saving implementation
2020-05-07 Fix uint8 overlow macro
    [zcl_freepadapp.h]
2020-05-09 Basic cluster reading fixes
    [preinclude.h, zcl_freepadapp.c, zcl_freepadapp.h, zcl_freepadapp_data.c]
2020-05-09 Refactor battery
2020-05-09 Set tx power 4dbm
2020-05-09 Fix battery voltage reporting
    [zcl_freepadapp.c]
2020-05-11 Send battery report one minute after join
2020-05-12 Fix attribute writing issue Save attrs to NV (initial code)
    [zcl_freepadapp.c, zcl_freepadapp.h, zcl_freepadapp_data.c]
2020-05-13 Save apptributes after basic reset
    [zcl_freepadapp.c]
2020-05-15 Put TL and reset buttons on different keys
2020-05-22 Add power out cluster
2020-07-08 temperature and humidity measurement
2020-07-14 Added sensors
    [f8wConfig.cfg]
2020-07-23 Adc stuff fixes
2020-07-24 Minor fixes
    [f8wConfig.cfg]
2020-07-25 Various fixes
    [f8wConfig.cfg]
2020-07-25 Refactor sensors reading task
2020-07-25 battery percentage reporting
2020-07-26 Refactore FN reset code
    [OSAL_App.c, zcl_app.c, zcl_app.h]
2020-07-27 Dynamic polrate adjustment
    [f8wConfig.cfg]
2020-07-29 Fix default sensor values
    [zcl_app_data.c]
2020-07-30 Update battery
2020-08-13 Add PWM generator for 555-les board
2020-08-14 Use internal pullups for 1wire and i2c
2020-08-23 Add PWM baterry discharge compensation formulas
2020-08-24 deprecate pwm/555 in favor to universal build
2020-08-29 Fix humidity adc
2020-09-13 Fix power consumption
    [f8wConfig.cfg]
2020-09-13 Generate 2Mhz on timer
2020-09-17 Update adc compensation formulas
2020-09-17 Pull-up before reading sensors
2020-09-17 tri state p0.7 (lumosity pin)
2020-09-19 Fix joining, send reports on HAL_KEY_PRESS
    [zcl_app.c]
2020-09-26 Fix date code attribute
    [zcl_app_data.c]
2020-09-29 Fix power saving
2020-09-29 Power off sensors on init
2020-10-01 Implement extended pressure attributes
2021-01-18 Fix, don't report scale attribute
    [zcl_app_data.c]
2021-01-29 added images, gerbers, bom, description
    [BOM_Flower.xlsx, BOM_Flower_V2.xlsx]
2021-04-21 use uart output
2021-04-21 Revert "Do only one wakeup cycle"
    This reverts commit 340a96fce2826ec9c99b3dd8207342343cedc8ef.
    [zcl_app.c, zcl_app.h]
2021-07-21 Changed former "out" clusters gathering all sensors data to "in" clusters according to the standard
